soldernerd/SolarChargerHardware/SolarCharger_RevF_BOM.xlsx

Sheet: Sheet1
Quantity | Description | Value | Package | Manufacturer | Model | Marking | Farnell | Parts | Unit Price | Price | Price inkl MwSt
1 | Board | n/a | 78x85mm | soldernerd.com | Solar Charger Rev D | Solar Charger Rev F | n/a | n/a | 3 | 3 | 3.26
4 | 3-pin-header | n/a | 200 mil | Weidmueller | PM5.08/3/90 | n/a | 1131854 | CON1, CON6 | 0.26 | 1.04 | 1.13
1 | 5-pin header | ICSP | 100MIL_5X |  | CON_5X100MIL |  |  | CON3 | 0.5 | 0.5 | 0.54
1 | Type B USB 2.0 Connector | n/a | USB B | Multicomp | USB-B-S-RA | n/a | 2112373 | CON2 | 0.6 | 0.6 | 0.65
2 | Type A USB connector | n/a | USB_A | Multicomp | MC32593 | n/a | 1696534 | X3, X4 | 0.532 | 1.064 | 1.16
1 | Low-power 8bit microcontroller with USB | PIC18F47J53 | TQFP44 | Microchip | PIC18F47J53 | PIC18F47J53 | 1815001 | IC5 | 4.07 | 4.07 | 4.42
1 | Crystal | 8MHz | 5mm x 3.2mm | Abracon | ABM3-8.000MHZ-D2Y-T | 080 | 2101329 | X2 | 0.7 | 0.7 | 0.76
1 | Crystal | 32.768kHz | 3.2mm x 1.5mm | Abracon | ABS07-120-32.768KHZ-T |  | 2467864 | X1 | 0.762 | 0.762 | 0.83
1 | EEPROM | 16Kbit | SOT23-5 | Microchip | 24AA16T-I/OT | B5xx | 1331290 | IC8 | 0.35 | 0.35 | 0.38
1 | 32MBit Serial Flash | 32MBit | EIAJ SOIC8 | Adesto | AT45DB321E |  | 2414318 | IC10 | 2.47 | 2.47 | 2.68
1 | 16-Bit, 4-Channel Analog-to-Digital Converter | n/a | SO14 | Microchip | MCP3428 |  | 1801128 | IC1 | 3.1 | 3.1 | 3.37
1 | Voltage Reference | 2.5V | SOT23 | Texas Instruments | REF2925AIDBZR |  | 2459773 | IC6 | 1.1 | 1.1 | 1.20 | 2459773 | Texas | REF2925AIDBZR
1 | Analog Temperature Sensors with Class-AB Output | LMT86 | SC70-5 | Texas Instruments | LMT86 |  | 2314388 | IC7 | 0.551 | 0.551 | 0.60
2 | Current-Shunt Monitors | Gain=50 | SC70-6 | Texas Instruments | INA213AIDCKT |  | 1754261 | IC2, IC4 | 1.35 | 2.7 | 2.93
1 | 15V, 75mA, 800kHz High Efficient Buck Converter | TPS62120 | SOT-23-8 | Texas Instruments | TPS62120 |  | 1864820 | IC9 | 1.5 | 1.5 | 1.63
1 | Synchronous Step-Down Converter | TPS54428 | SOIC8_PWRPAD | Texas Instruments | TPS54428 |  | 2078519 | IC11 | 1.97 | 1.97 | 2.14
2 | 1.5A Dual MOSFET Driver | n/a | SSOP8 | Microchip | MCP14A0153-E/MS |  | 2524543 | IC12, IC13 | 0.76 | 1.52 | 1.65
1 | 85V Half-Bridge MOSFET Driver | n/a | SOIC8 | Microchip | MIC4605-1YM | MIC4605 | 2510168 | IC3 | 0.767 | 0.767 | 0.83
2 | Resistor | 7mOhms 1% 1W | 1206, metric 3216 | TE Connectivity | TLR2B10DR007FTDG | n/a | 2332217 | R3, R7 | 0.9 | 1.8 | 1.96
1 | Resistor | 5R6 | 0805, metric 2012 |  | RESISTORR0805 |  |  | R6 | 0.1 | 0.1 | 0.11
3 | Resistor | 1k | 0805, metric 2012 | Multicomp |  |  |  | R33, R34, R35 | 0.01 | 0.03 | 0.03
5 | Resistor | 10k | 0805, metric 2012 | Multicomp | MCWR08X1002FTL | 1002 | 2447553 | R2, R9, R11, R12, R13 | 0.01 | 0.05 | 0.05
1 | Resistor | 22k | 0805, metric 2012 | Multicomp | MC01W0805122K |  | 9332820 | R30 | 0.01 | 0.01 | 0.01
2 | Resistor | 27k | 0805, metric 2012 | Multicomp | MC01W0805127K |  | 9332952 | R25, R27 | 0.01 | 0.02 | 0.02
1 | Resistor | 43k | 0805, metric 2012 | Multicomp | MC01W0805143K |  | 9333223 | R19 | 0.01 | 0.01 | 0.01
2 | Resistor | 51k | 0805, metric 2012 | Multicomp | MC01W0805151K |  | 9333339 | R20, R22 | 0.01 | 0.02 | 0.02
2 | Resistor | 68k | 0805, metric 2012 | Multicomp | MC01W0805168K |  | 9333487 | R24, R26 | 0.01 | 0.02 | 0.02
1 | Resistor | 75k | 0805, metric 2012 | Multicomp | MC01W0805175K |  | 9333541 | R21 | 0.01 | 0.01 | 0.01
2 | Resistor | 100k | 0805, metric 2012 | Multicomp | MCWR08X1003FTL |  | 2447551 | R1, R8 | 0.01 | 0.02 | 0.02
1 | Resistor | 220k | 0805, metric 2012 | Multicomp | MC01W08051220K |  | 9332839 | R29 | 0.01 | 0.01 | 0.01
5 | Resistor | 300k | 0805, metric 2012 | Multicomp | MC01W08051300K |  | 9333010 | R5, R10, R17, R28, R32 | 0.01 | 0.05 | 0.05
4 | Resistor | 620k | 0805, metric 2012 | Multicomp | MC01W08051620K |  | 9333444 | R4, R14, R16, R31 | 0.01 | 0.04 | 0.04
2 | Ceramic capacitor | 6p8 | 0805, metric 2012 |  | CC0805 |  |  | C18, C19 | 0.2 | 0.4 | 0.43
4 | Ceramic capacitor | 15p | 0805, metric 2012 |  | CC0805 |  |  | C20, C21, C27, C42 | 0.2 | 0.8 | 0.87
25 | Ceramic capacitor | 100nF, 50V, X7R | 0805, metric 2012 | Multicomp | MC0805B104K500CT | n/a | 1759265 | C1, C2, C3, C7, C8, C9, C11, C12, C13, C14, C16, C17, C23, C24, C26, C29, C30, C33, C34, C36, C37, C38, C41, C43, C44 | 0.015 | 0.375 | 0.41
5 | Ceramic capacitor | 1u 25V | 0805, metric 2012 | Murata | GRM219R71E105KA88D |  | 1845770 | C22, C35, C45, C46, C47 | 0.052 | 0.26 | 0.28
4 | Ceramic capacitor | 10uF, 25V, X7R | 1206, metric 3216 | Multicomp | MC0805B106K6R3CT | n/a | 2320851 | C6, C25, C31, C32 | 0.062 | 0.248 | 0.27
4 | Ceramic capacitor | 22u 6V3 | 1206, metric 3216 | TDK | C3216X5R0J226M085AC |  | 2526272 | C15, C28, C39, C40 | 0.16 | 0.64 | 0.70
3 | Electrolytic capacitor | 470u 25V | 10mm x 12.5mm | Panasonic | EEUFR1E471B |  | 1800650 | C4, C5, C10 | 0.27 | 0.81 | 0.88
1 | Inductor | 18u | 2.95mm x 2.95mm x 1.4mm | Coilcraft | LPS3015-183MRB |  | 2408026 | L2 | 0.95 | 0.95 | 1.03
1 | Inductor | 4.7u | 10.2mm x 10.2mm x 4.8mm | Coilcraft | MSS1048-472NLC |  | 2288282 | L3 | 1.86 | 1.86 | 2.02
1 | Inductor | 22uH | 12mm x 12mm | Coilcraft | MSS1210-223MED | 226 | 2288332 | L1 | 2.5 | 2.5 | 2.72
4 | Schottky diode | n/a | SOD123-W | NXP | PMEG3010BER | n/a | 1907684 | D1, D2, D3, D4 | 0.17 | 0.68 | 0.74
1 | Zener diode | 15V | DO214AC |  |  |  |  | D6 | 0.3 | 0.3 | 0.33
1 | Zener diode | 18V | DO214AC |  |  |  |  | D5 | 0.3 | 0.3 | 0.33
6 | N-Channel MOSFET | n/a | SOT23 | NXP | NX3008NBKW |  | 2069546 | Q1, Q3, Q7, Q8, Q9, Q15 | 0.05 | 0.3 | 0.33
2 | P-channel MOSFET | n/a | SOT23 | On Semiconductor | NTR4101PT1G |  | 2124699 | Q4, Q10 | 0.14 | 0.28 | 0.30
7 | N-Channel MOSFET | 30V | LFPAK / SOT669 | NXP | PSMN6R0-30YL |  | 1699709 | Q2, Q5, Q6, Q11, Q12, Q13, Q14 | 0.425 | 2.975 | 3.23
 |  |  |  |  |  |  |  |  |  | 43.632 | 47.42608696
 |  |  |  |  |  |  |  |  |  |  | 49.40217391
 |  |  |  |  |  |  |  |  |  |  | 51.46059783
 |  |  |  |  |  |  |  |  |  |  | 75
 |  |  |  |  |  |  |  |  |  |  | 2.5
 |  |  |  |  |  |  |  |  |  |  | 187.5

Sheet: Sheet2
Qty | Value | Device | Package | Parts | Description
1 | 24AA16 | 24AA16 | SOT-23-5 | IC8 | 16K I2C Serial EEPROM
1 | AT45DB321E | AT45DB161EEIAJ | EIAJ_SOIC8 | IC10 | 16-Mbit DataFlash
3 | 470u 25V | C_POLARIZED10MM | 10MM | C4, C5, C10
25 | 100n | CC0805 | C0805 | C1, C2, C3, C7, C8, C9, C11, C12, C13, C14, C16, C17, C23, C24, C26, C29, C30, C33, C34, C36, C37, C38, C41, C43, C44 | Capacitor
4 | 15p | CC0805 | C0805 | C20, C21, C27, C42 | Capacitor
5 | 1u | CC0805 | C0805 | C22, C35, C45, C46, C47 | Capacitor
2 | 6p8 | CC0805 | C0805 | C18, C19 | Capacitor
4 | 10u 25V | CC1206 | C1206 | C6, C25, C31, C32 | Capacitor
4 | 22u 6V3 | CC1206 | C1206 | C15, C28, C39, C40 | Capacitor
1 | CON_2X100MIL | CON_2X100MIL | 100MIL_2X | CON7 | 2-pin header
2 | CON_3X100MIL | CON_3X100MIL | 100MIL_3X | CON4, CON5 | 3-pin header
1 | I2C | CON_4X100MIL | 100MIL_4X | CON8 | 4-pin header
1 | CON_4X200MIL | CON_4X200MIL | 200MIL_4X | CON1 | 4-pin header
1 | CON_5X100MIL | CON_5X100MIL | 100MIL_5X | CON11 | 5-pin header
1 | SPI | CON_6X3X2 | 100MIL_3X2 | CON9 | 6-pin header
1 | CON_8X200MIL | CON_8X200MIL | 200MIL_8X | CON6 | 8-pin header
1 | ABS07-120-32.768KHZ-T | CRYSTAL3.2X1.5 | 3.2X1.5MM | X1 | Crystal
1 | ABM3-8.000MHZ-D2Y-T | CRYSTAL5X3.2MM | 5X3.2MM | X2 | Crystal
1 | DISPLAY_UNIT | DISPLAY_UNIT | DISPLAY_UNIT | BRD1 | Display Unit
2 | INA213 | INA21 | SC70-6 | IC2, IC4 | Current-Shunt Monitors
1 | 18u | INDUCTORLPS3015 | LPS3015 | L2
1 | 4.7u | INDUCTORMSS1038 | MSS1038 | L3
1 | 22uH | INDUCTORMSS1210 | MSS1210 | L1
1 | LMT86 | LMT86 | SC70-5 | IC7 | Analog Temperature Sensors with Class-AB Output
2 | MCP14A0153 | MCP14A0153 | SSOP8 | IC12, IC13 | 1.5A Dual MOSFET Driver with Low Threshold Input And Enable
1 | MCP3428 | MCP3428 | SO14 | IC1 | 16-Bit, 4-Channel ΔΣ Analog-to-Digital Converter with
1 | MIC4605-1YM | MIC4605 | SOIC8 | IC3 | 85V Half-Bridge MOSFET Driver with adaptive Dead Time
6 | NX3008NBKW | N-FETSOT23 | SOT23 | Q1, Q3, Q7, Q8, Q9, Q15 | N-Channel MOSFET
4 | N-FET | N-PWR-MOSFETLFPAK | LFPAK | Q11, Q12, Q13, Q14
3 | PSMN6R0-30YL | N-PWR-MOSFETLFPAK | LFPAK | Q2, Q5, Q6
1 | PCB_115_90 | PCB_115_90 | PCB_115_90 | DRL1
2 | NTR4101PT1G | P-FETSOT23 | SOT23 | Q4, Q10
1 | PIC18F47J53 | PIC18F46J50 | TQFP44 | IC5 | Low-power 8bit microcontroller with USB
2 | 100k | RESISTORR0805 | R0805 | R1, R8 | RESISTOR, European symbol
5 | 10k | RESISTORR0805 | R0805 | R2, R9, R11, R12, R13 | RESISTOR, European symbol
3 | 1k | RESISTORR0805 | R0805 | R33, R34, R35 | RESISTOR, European symbol
1 | 220k | RESISTORR0805 | R0805 | R29 | RESISTOR, European symbol
1 | 22k | RESISTORR0805 | R0805 | R30 | RESISTOR, European symbol
2 | 27k | RESISTORR0805 | R0805 | R25, R27 | RESISTOR, European symbol
5 | 300k | RESISTORR0805 | R0805 | R5, R10, R17, R28, R32 | RESISTOR, European symbol
1 | 43k | RESISTORR0805 | R0805 | R19 | RESISTOR, European symbol
2 | 51k | RESISTORR0805 | R0805 | R20, R22 | RESISTOR, European symbol
1 | 5R6 | RESISTORR0805 | R0805 | R6 | RESISTOR, European symbol
4 | 620k | RESISTORR0805 | R0805 | R4, R14, R16, R31 | RESISTOR, European symbol
2 | 68k | RESISTORR0805 | R0805 | R24, R26 | RESISTOR, European symbol
1 | 75k | RESISTORR0805 | R0805 | R21 | RESISTOR, European symbol
2 | TBD | RESISTORR0805 | R0805 | R18, R23 | RESISTOR, European symbol
2 | R007 | RESISTORR1206 | R1206 | R3, R7 | RESISTOR, European symbol
4 | PMEG3010BER | SCHOTTKYSOD123 | SOD123 | D1, D2, D3, D4
1 | TPS54428 | TPS54428 | SOIC8_PWRPAD | IC11 | 4.5V to 18V Input, 4-A Synchronous Step-Down Converter with Eco-mode
1 | TPS62120 | TPS62120 | SOT-23-8 | IC9 | 15V, 75mA, 800kHz High Efficient Buck Converter
1 | TI_REF2925 | TS6001 | SOT23 | IC6 | 2.5V Voltage Reference in SOT23
2 | USB_A | USB_A | USB_A | X3, X4
1 | USB_BMULTICOMP | USB_BMULTICOMP | USB_B | CON2 | Type B USB connector
1 | 15V | ZENERDO214 | DO214AC | D6
1 | 18V | ZENERDO214 | DO214AC | D5
2 USB_A USB_A USB_A X3, X4
1 USB_BMULTICOMP USB_BMULTICOMP USB_B CON2 Type B USB connector
