soldernerd/SolarChargerHardware/(threads)

Thread 1 (2020-04-01):

Additional feature request

Mssekibaala, 2020-04-01:
It would be nice for the charger pcb to expose an interrupt pin and at least 2 GPIO pins. Perhaps a Version G?

soldernerd, 2020-04-15:
There are no pins left on the microcontroller but you can potentially use the two external temperature sensor inputs for that purpose

Mssekibaala, 2020-04-16:
Thank you Lukas. Let me look into it that. This is my first time working
with the PIC MCU coming from an Arduino only background but I am sure I'll
figure it. Thanks for putting this out there for us all to use.

Cheers

On Wed, Apr 15, 2020 at 5:35 PM Lukas Fässler <notifications@github.com>
wrote:

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
