soldernerd/SolarChargerHardware/SolarCharger_Rev2_Board.pdf

Q1
L1

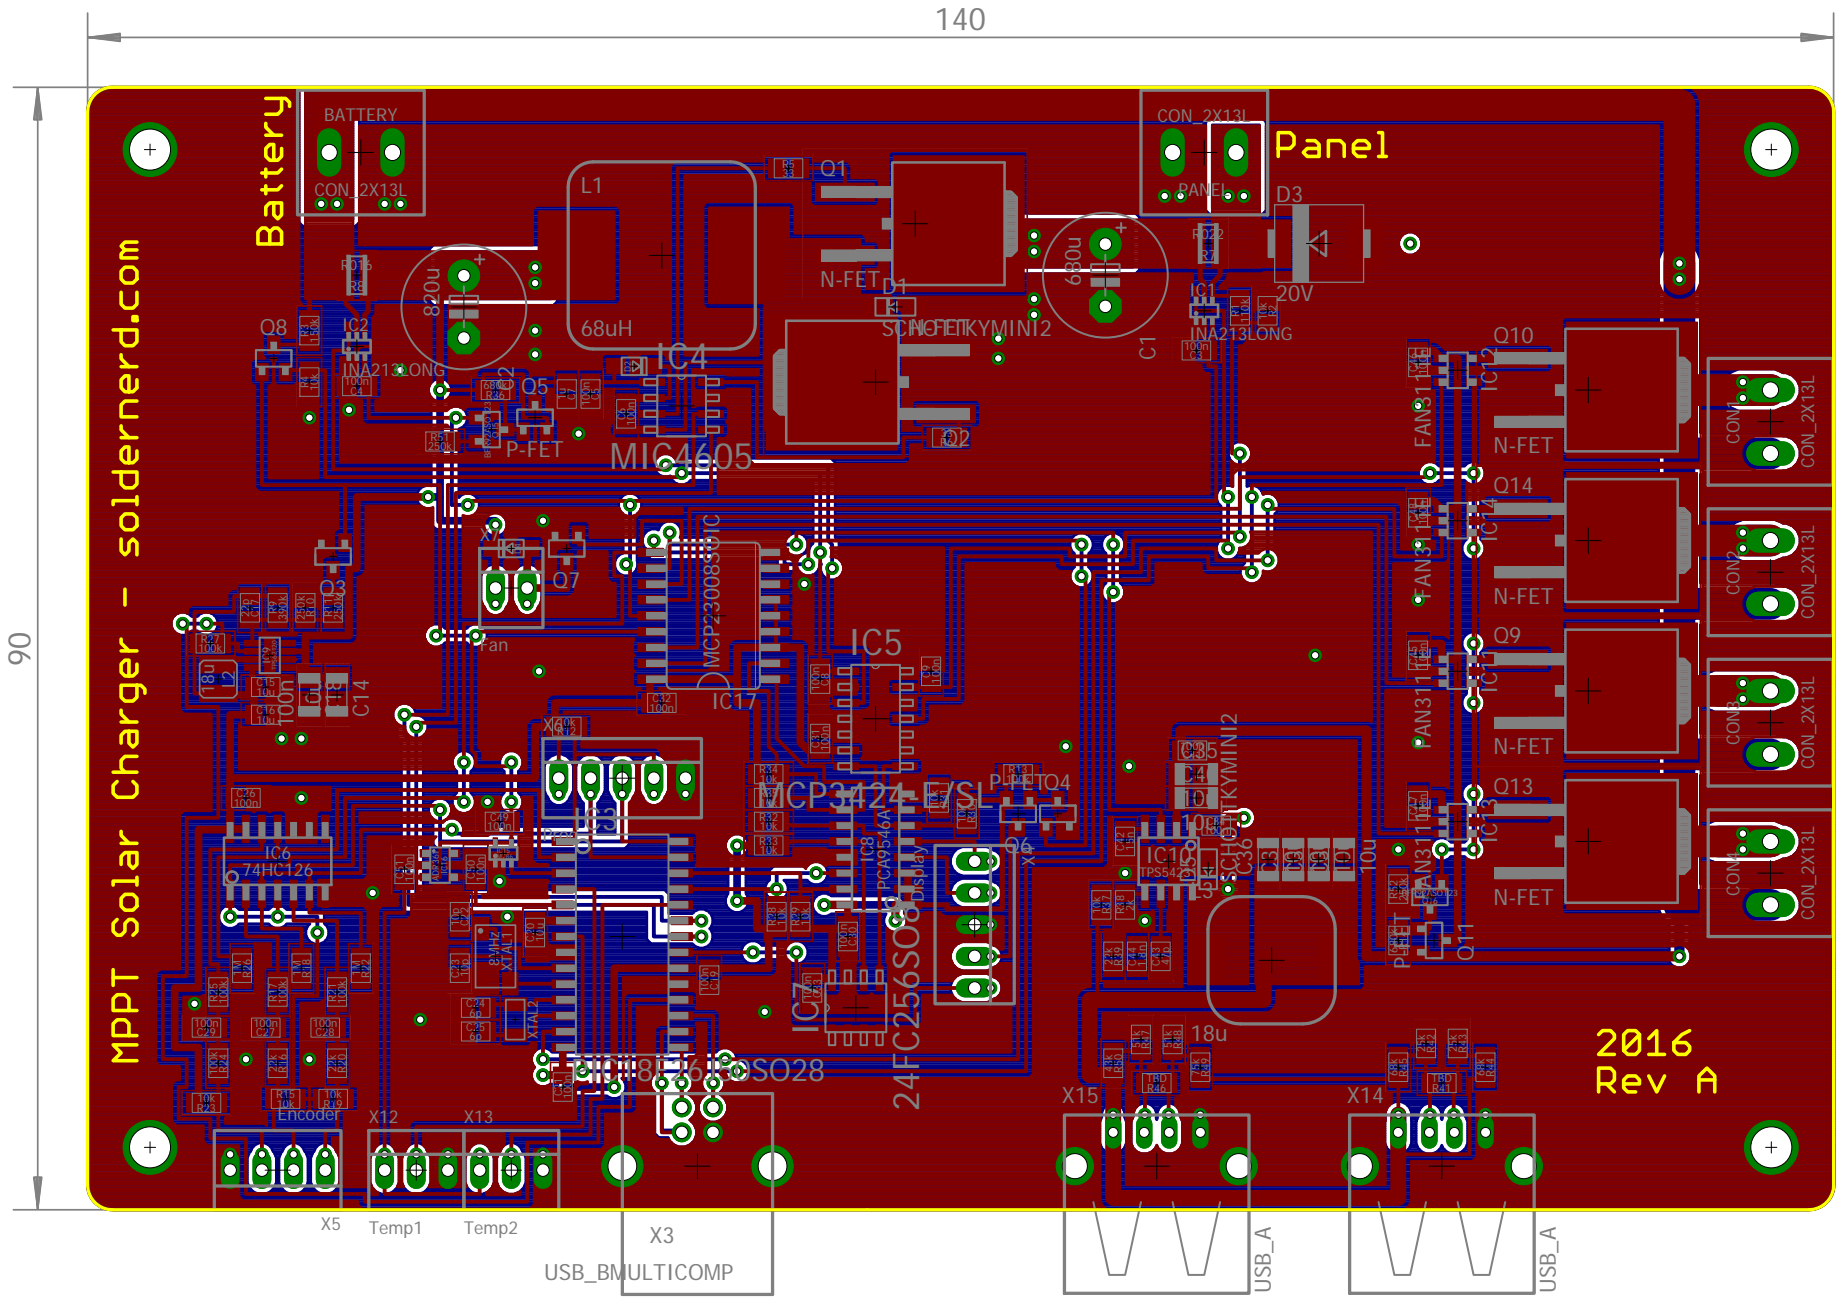
[picture p1: page 1]

MIC4605 P-FET
