soldernerd/SolarChargerHardware/SolarCharger_Rev2_Schematic.pdf

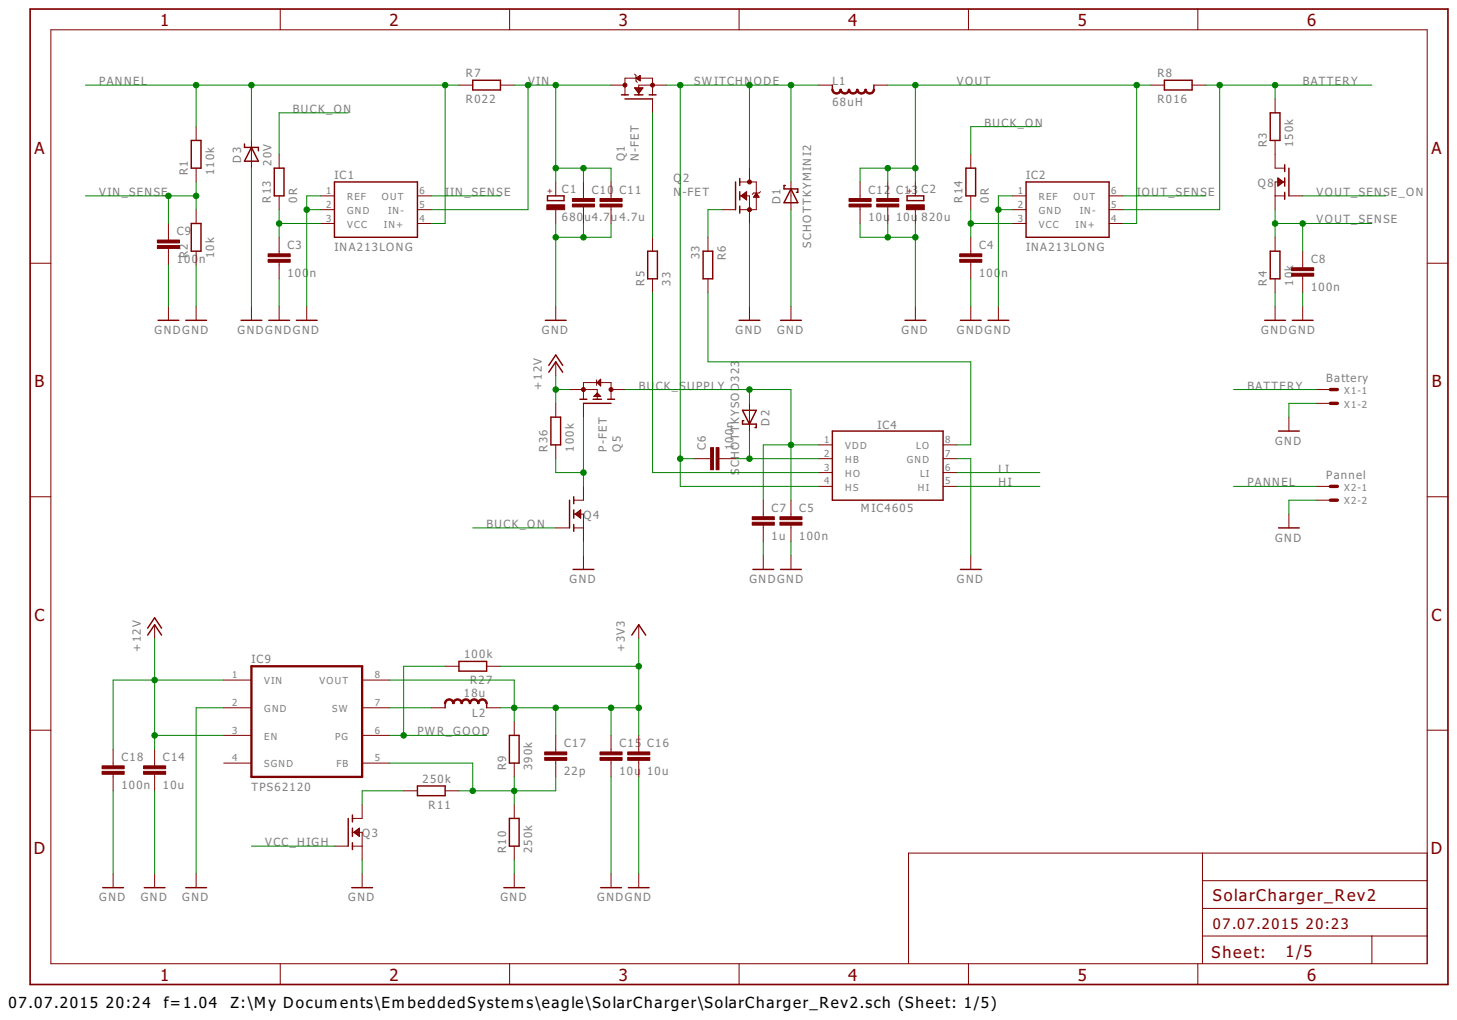
[picture p2: page 1]

07.07.2015 20:24 f=1.04 Z:\My Documents\EmbeddedSystems\eagle\SolarCharger\SolarCharger_Rev2.sch (Sheet: 1/5)

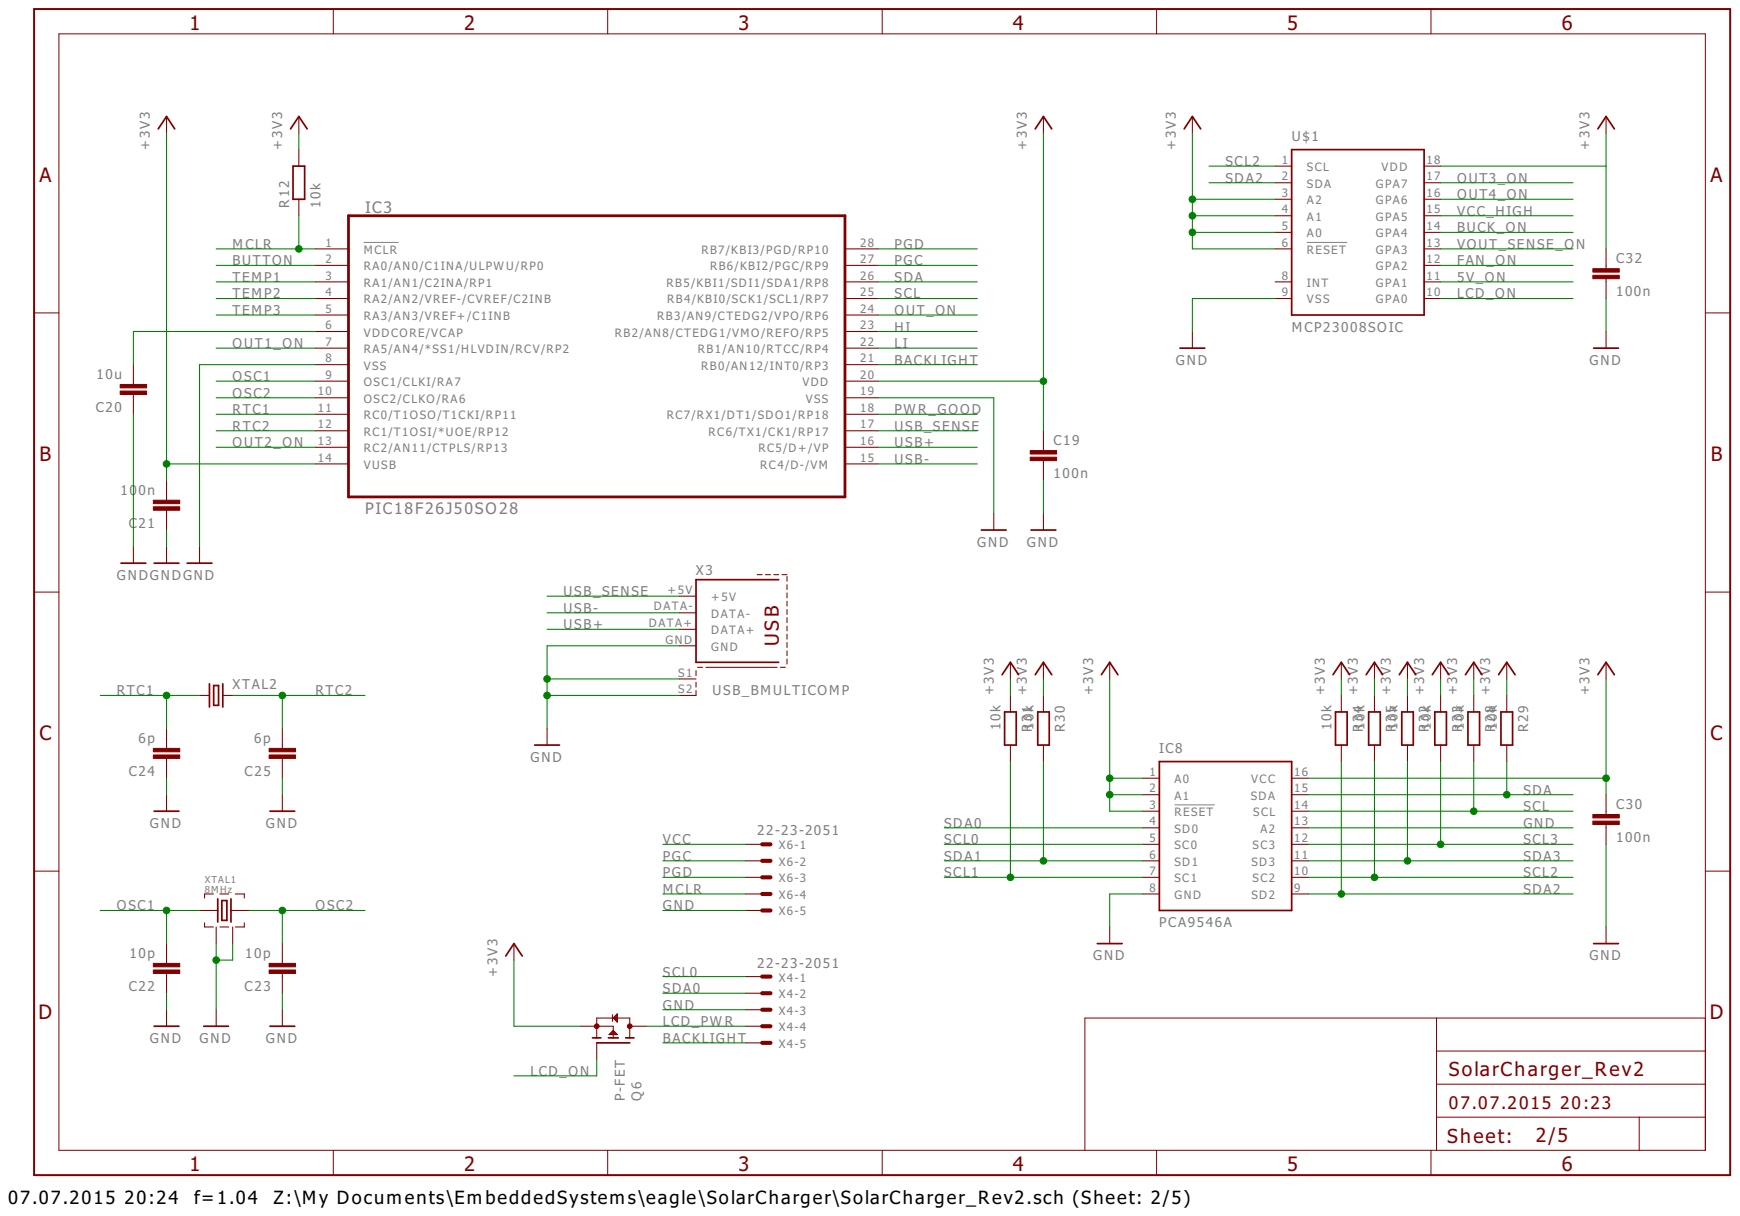
[picture p3: page 2]

07.07.2015 20:24 f=1.04 Z:\My Documents\EmbeddedSystems\eagle\SolarCharger\SolarCharger_Rev2.sch (Sheet: 2/5)

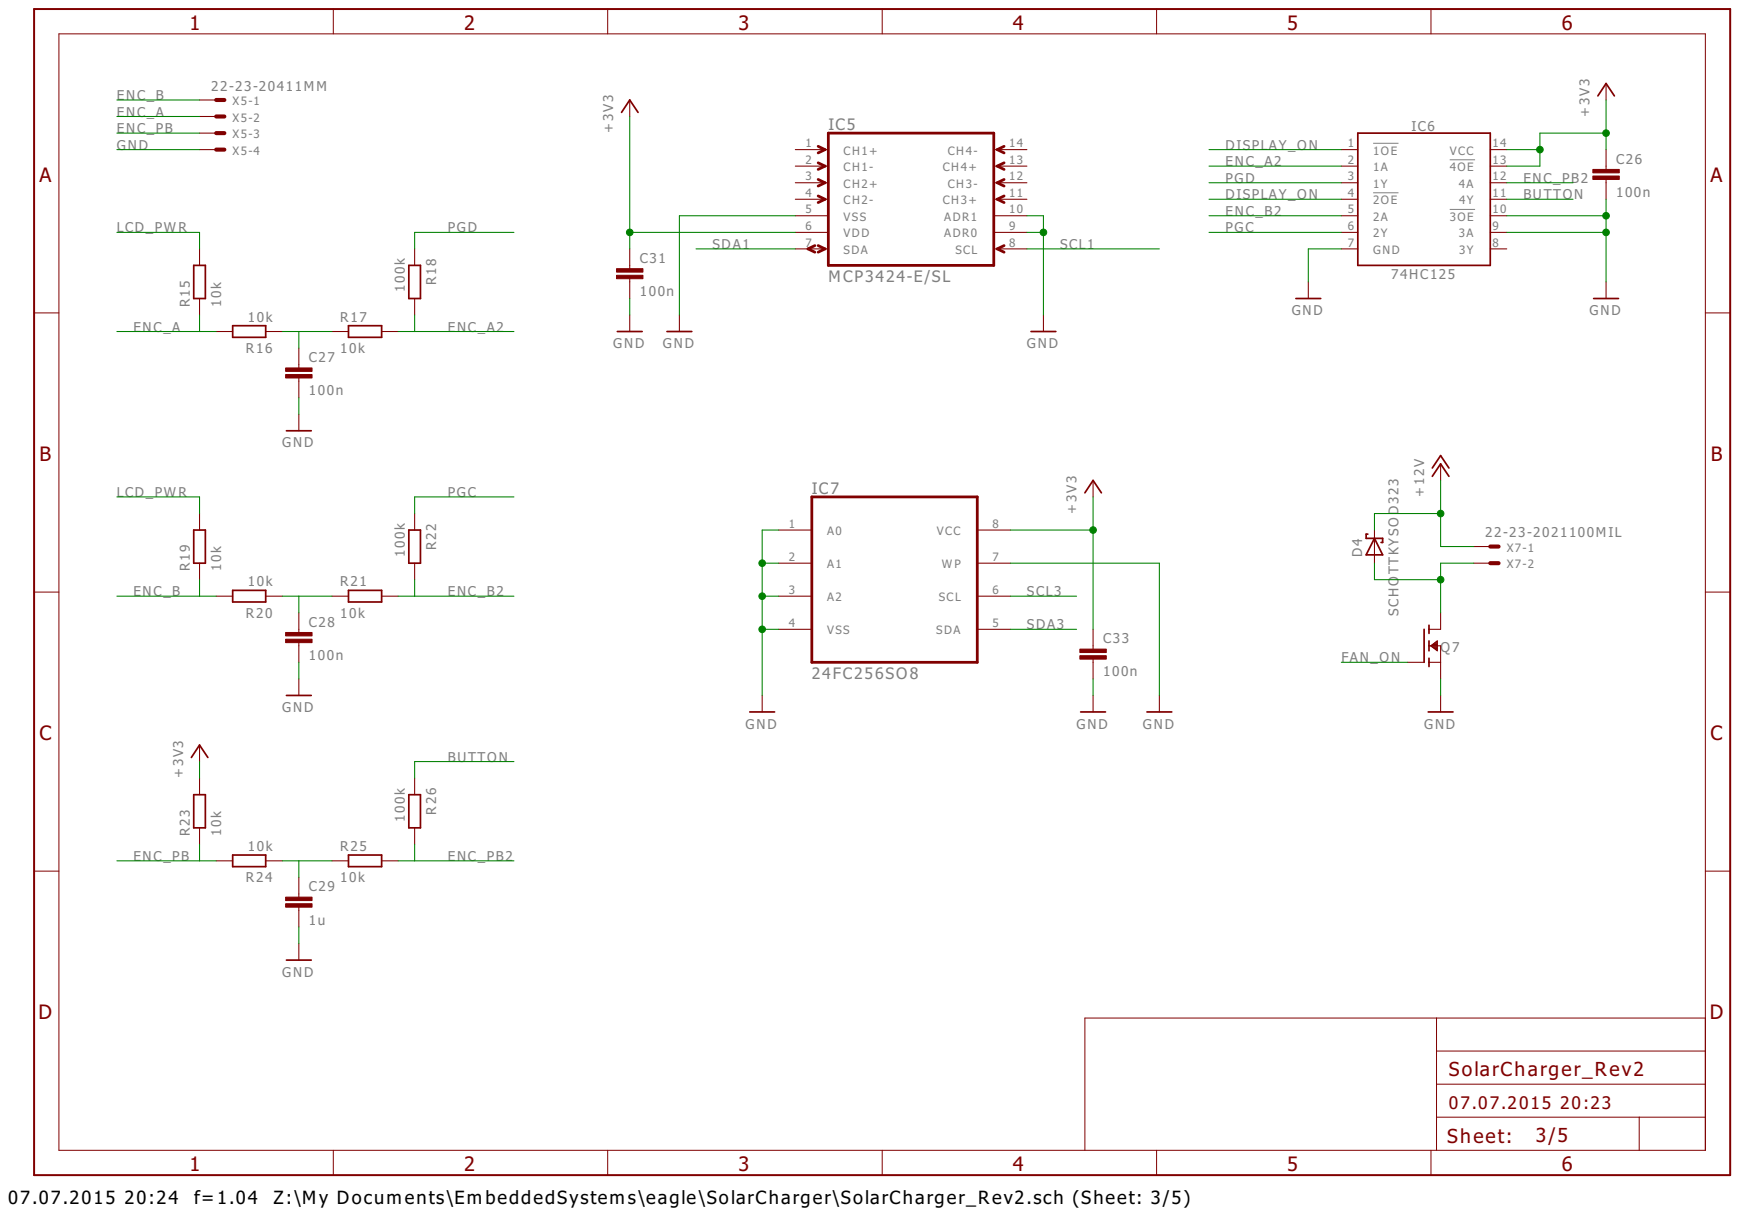
[picture p4: page 3]

07.07.2015 20:24 f=1.04 Z:\My Documents\EmbeddedSystems\eagle\SolarCharger\SolarCharger_Rev2.sch (Sheet: 3/5)

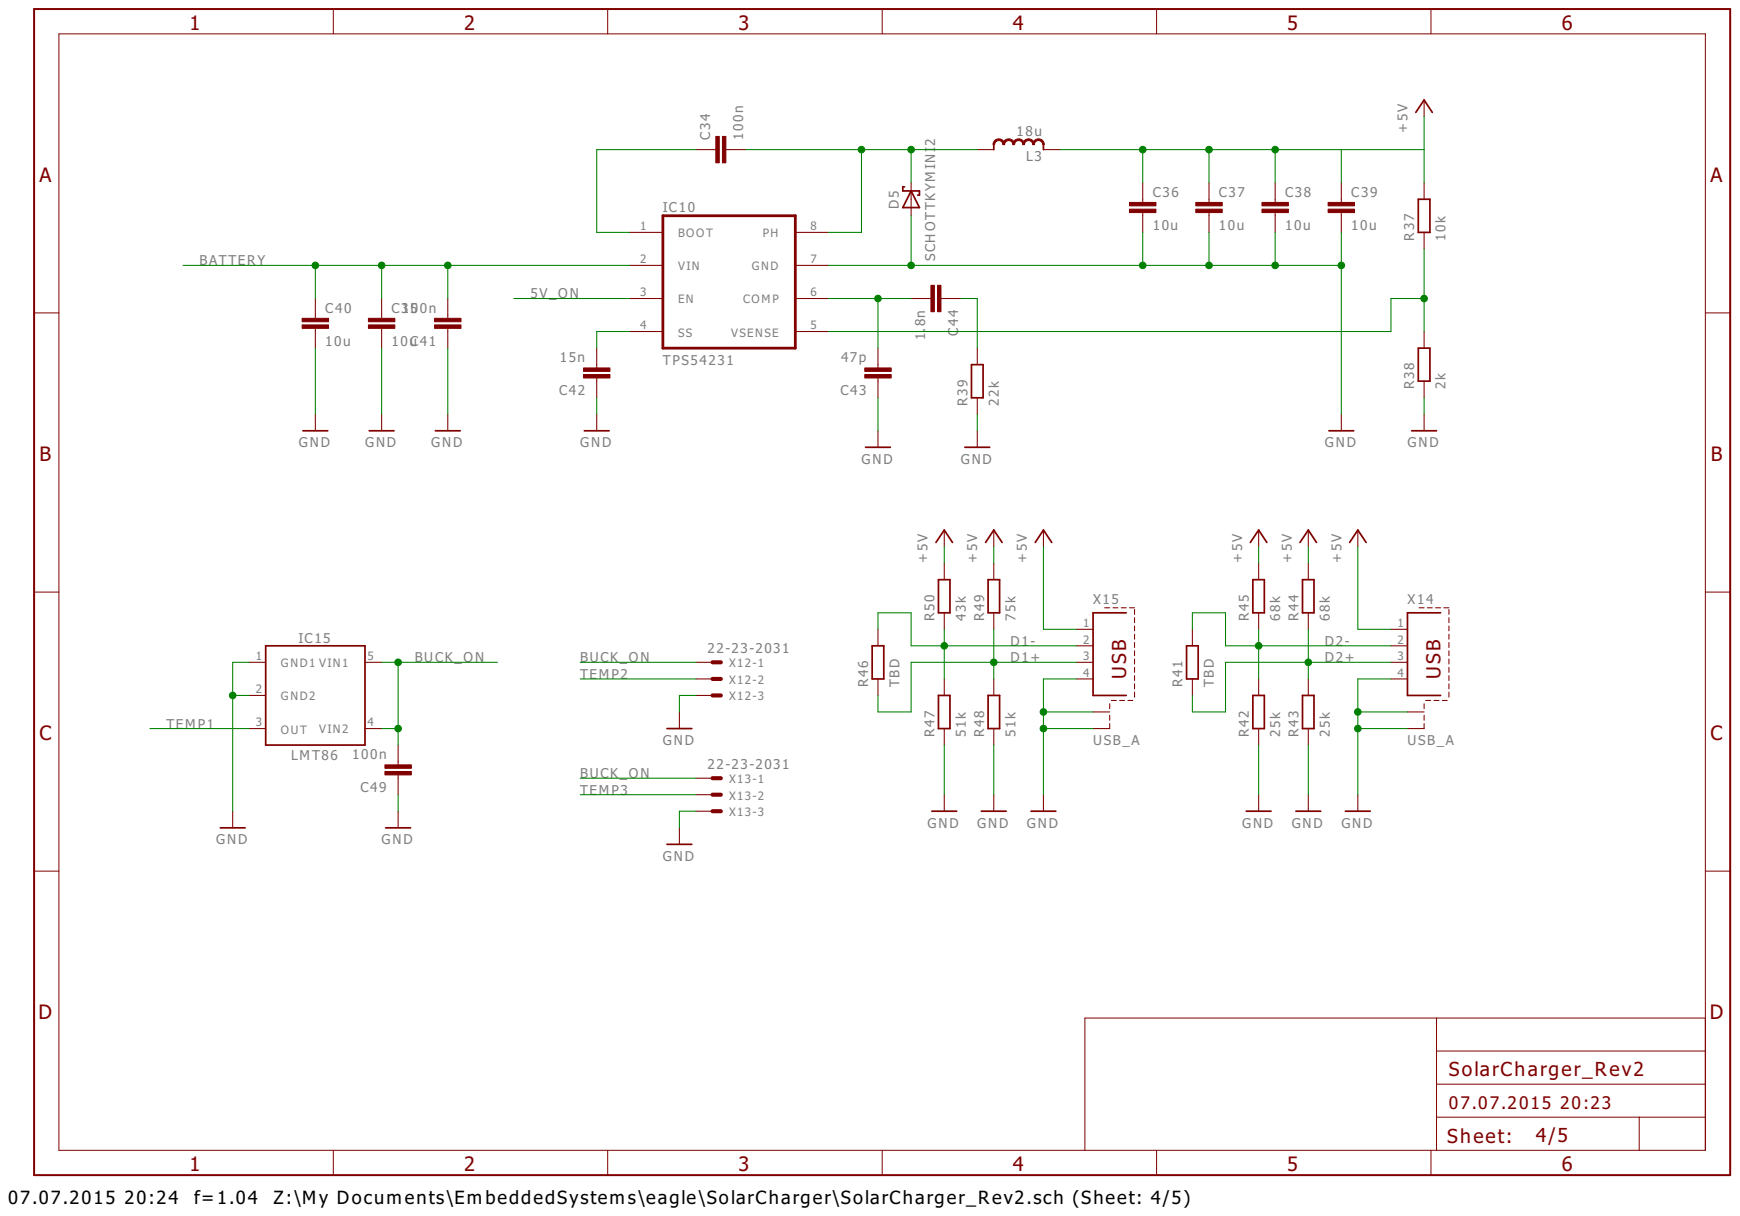
[picture p5: page 4]

07.07.2015 20:24 f=1.04 Z:\My Documents\EmbeddedSystems\eagle\SolarCharger\SolarCharger_Rev2.sch (Sheet: 4/5)

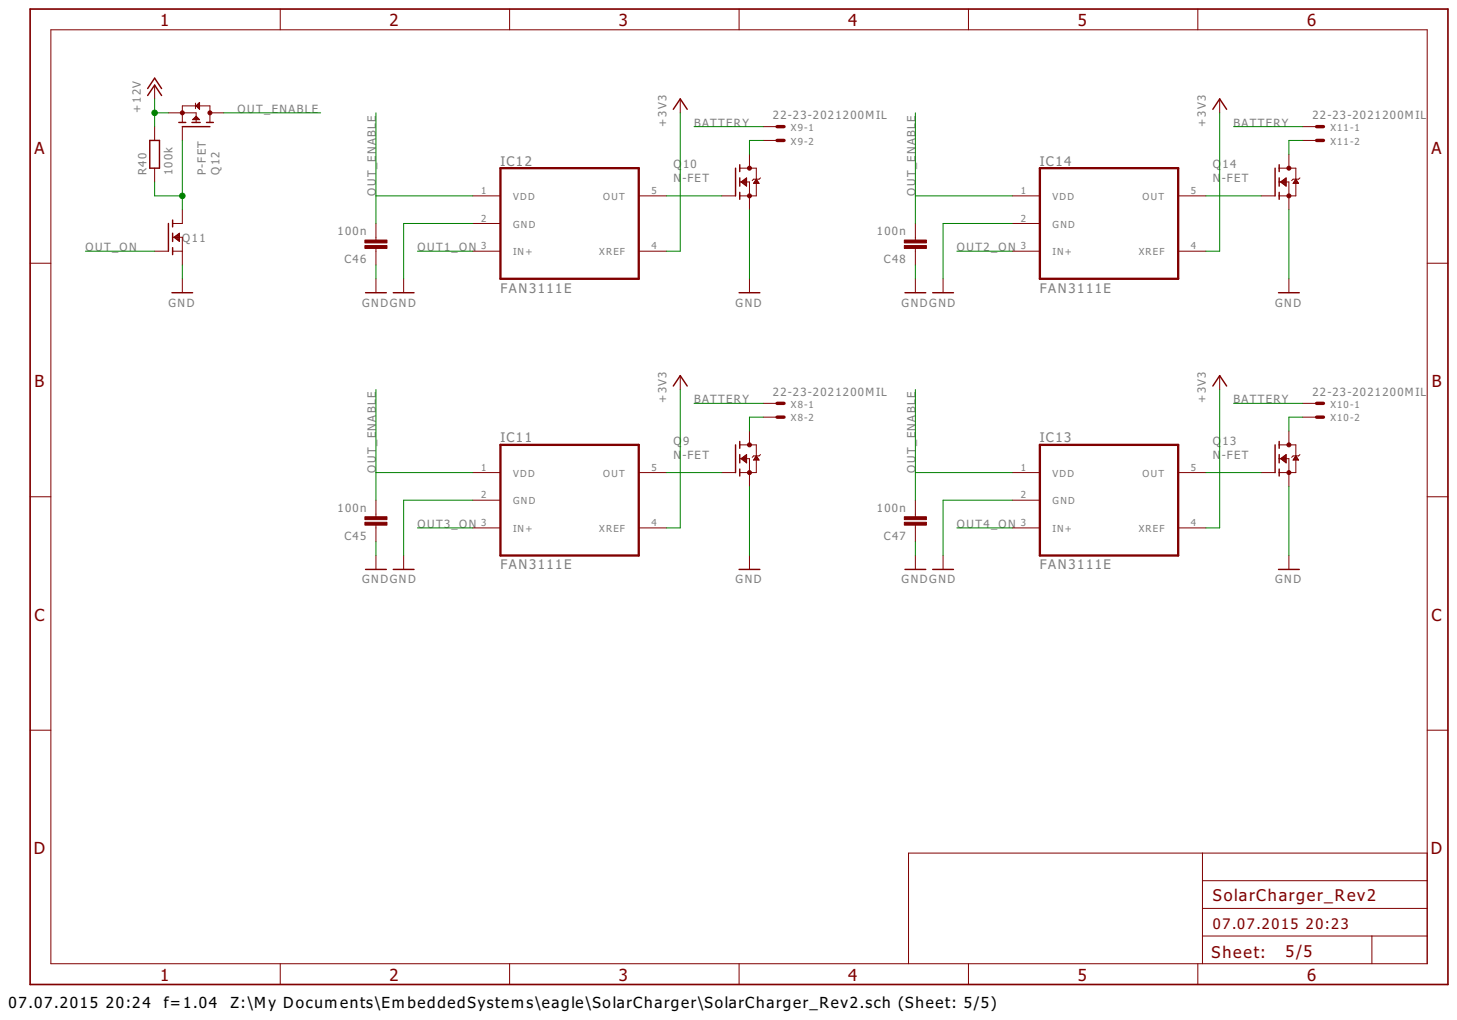
[picture p6: page 5]

07.07.2015 20:24 f=1.04 Z:\My Documents\EmbeddedSystems\eagle\SolarCharger\SolarCharger_Rev2.sch (Sheet: 5/5)
