soldernerd/SolarChargerHardware/SolarCharger_Rev1_Board.pdf

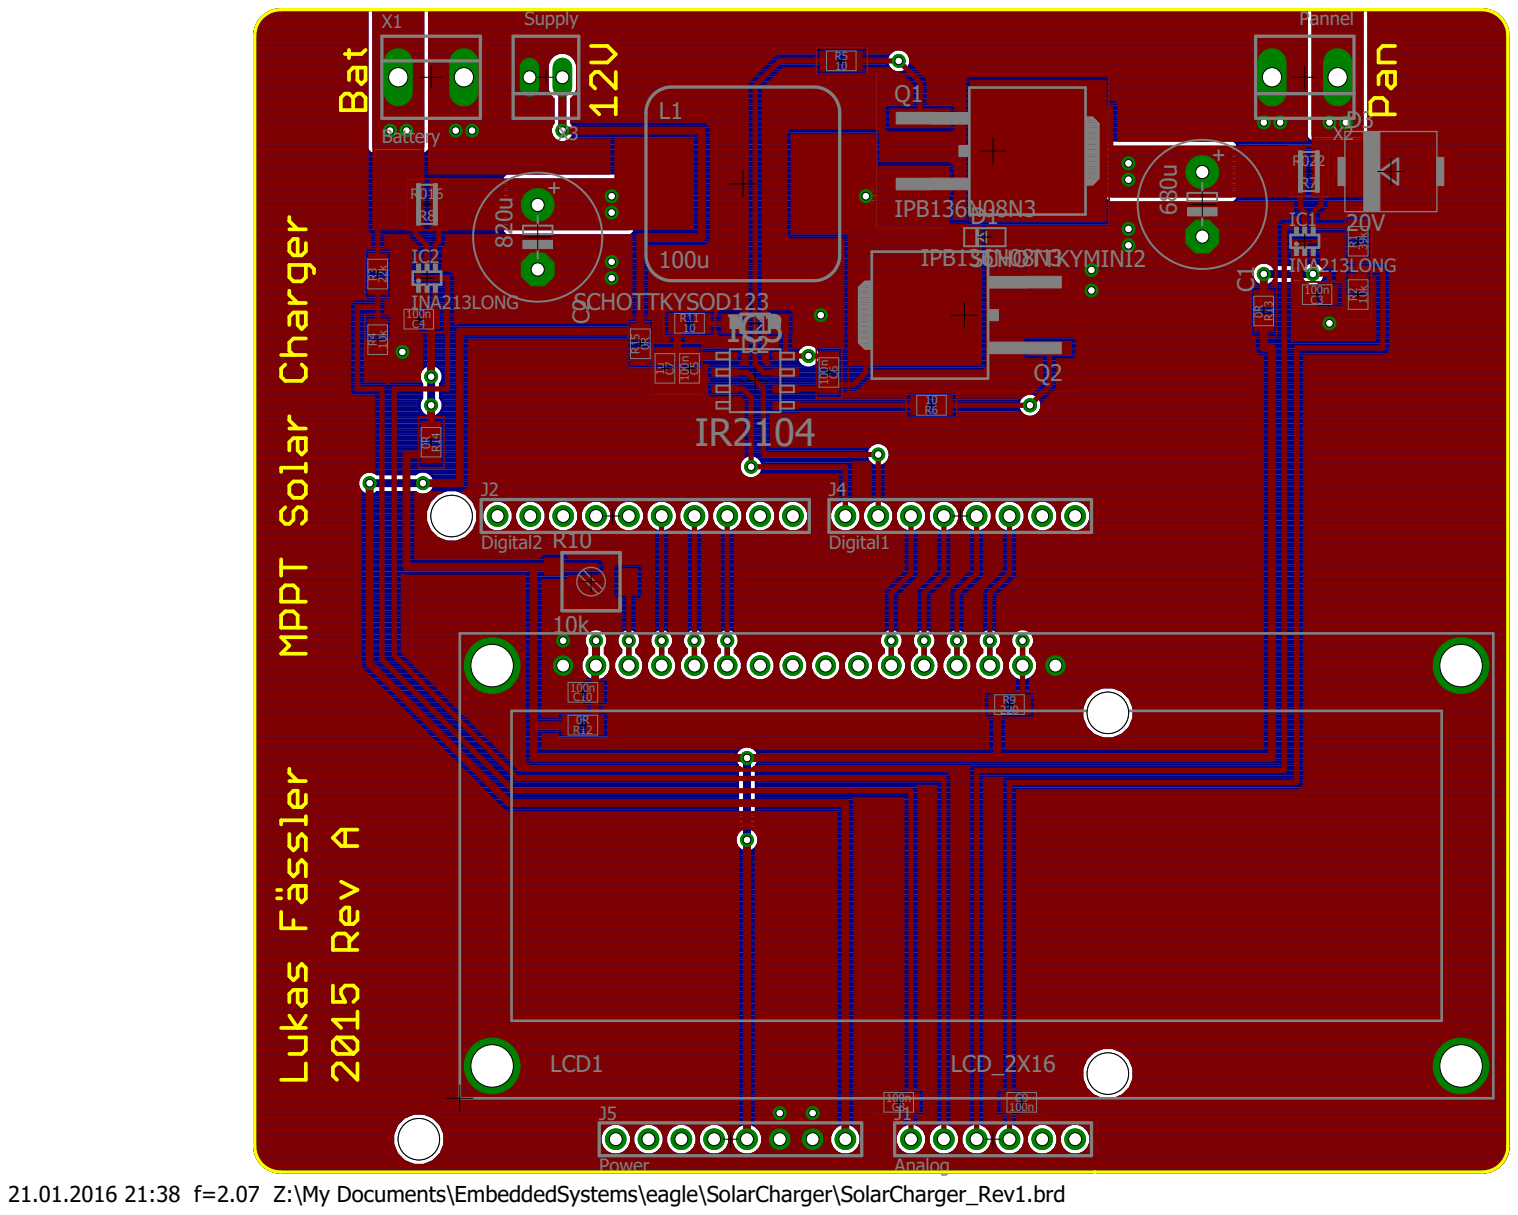
[picture p7: page 1]

X1 | Supply Pannel

R5
10
Q1

R022
R7

R016
R8 | D1 | IC1 | 20V

IPB136N08N3

IC2 | 100u | IPB13S6CNH0O8TNT3KYMINI2

INA213LONG

INA213LONG | SCHOTTKYSOD123
C3 C4
100n

R6

C10 | R9

0R
R12

21.01.2016 21:38 f=2.07 Z:\My Documents\EmbeddedSystems\eagle\SolarCharger\SolarCharger_Rev1.brd
