soldernerd/SolarChargerHardware/SolarCharger_Rev1_Schematic.pdf

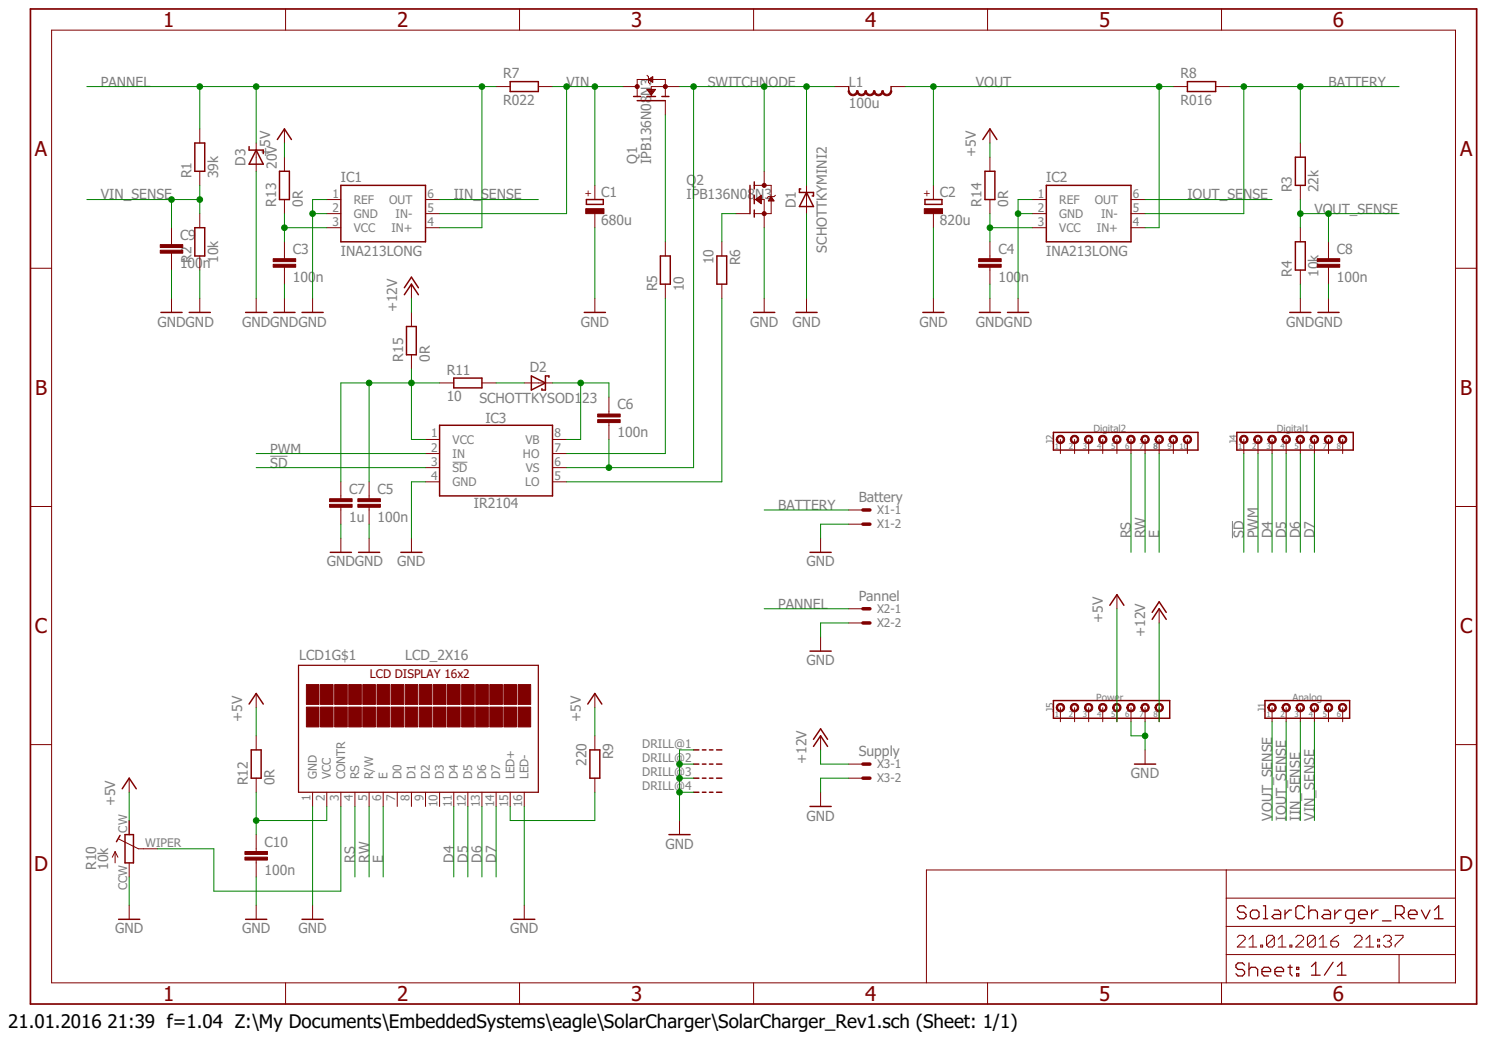
[picture p8: page 1]

21.01.2016 21:39 f=1.04 Z:\My Documents\EmbeddedSystems\eagle\SolarCharger\SolarCharger_Rev1.sch (Sheet: 1/1)
