soldernerd/SolarChargerHardware/SolarCharger_Rev1_revised.brd

## EAGLE design SolarCharger_Rev1_revised.brd (2018-06-25)

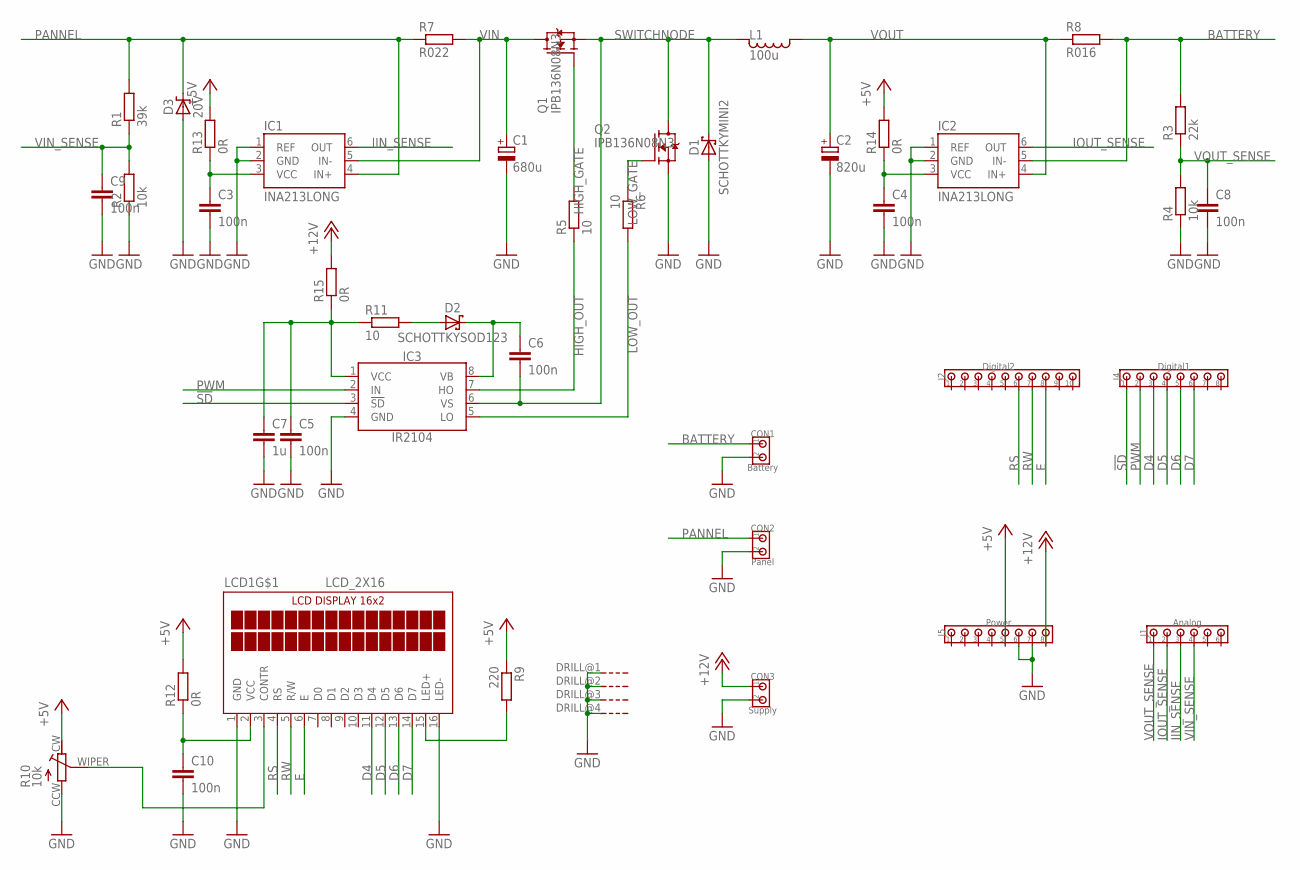
[picture p9: schematic SolarCharger_Rev1_revised.sch]

Parts:
C1: 680u; 10MM
C2: 820u; 10MM
C3, C4, C5, C6, C8, C9, C10: 100n; C0805
C7: 1u; C0805
CON1: Battery; 200MIL_2X
CON2: Panel; 200MIL_2X
CON3: Supply; 200MIL_2X
D1: SCHOTTKYMINI2; MINI2-F3-B
D2: SCHOTTKYSOD123; SOD123
D3: 20V; SMC
IC1, IC2: INA213LONG; SC70-6_LONG
IC3: IR2104; SOIC8
J1: Analog; 100MIL_6X_ROUND
J2: Digital2; 100MIL_10X_ROUND
J4: Digital1; 100MIL_8X_ROUND
J5: Power; 100MIL_8X_ROUND
L1: 100u; MSS1583
LCD1: LCD_2X16
Q1: IPB136N08N3; TO263-3
Q2: IPB136N08N3; TO263-3@1
R1: 39k; R0805
R2, R4: 10k; R0805
R3: 22k; R0805
R5, R6, R11: 10; R0805
R7: R022; 0612
R8: R016; 0612
R9: 220; R0805
R10: 10k; RTRIM3314G
R12, R13, R14, R15: 0R; R0805

Connections:
!SD!: IC3.3 (!SD!), J4.1
+5V: J5.5, R9.1, R10.CW, R12.2, R13.2, R14.2
+12V: CON3.1, J5.8, R15.2
BATTERY: CON1.1, IC2.5 (IN-), R3.2, R8.2
BOOT: C6.1, D2.C, IC3.8 (VB)
D4: J4.3, LCD1.11 (D4)
D5: J4.4, LCD1.12 (D5)
D6: J4.5, LCD1.13 (D6)
D7: J4.6, LCD1.14 (D7)
E: J2.8, LCD1.6 (E)
GND: C1.-, C2.-, C3.2, C4.2, C5.2, C7.2, C8.2, C9.2, C10.2, CON1.2, CON2.2, CON3.2, D1.A, D3.A, IC1.1 (REF), IC1.2 (GND), IC2.1 (REF), IC2.2 (GND), IC3.4 (GND), J5.6, J5.7, LCD1.1 (GND), LCD1.16 (LED-), LCD1.DRILL@1 (G), LCD1.DRILL@2 (G), LCD1.DRILL@3 (G), LCD1.DRILL@4 (G), Q2.3 (S), R2.1, R4.1, R10.CCW
HIGH_GATE: Q1.1 (G), R5.2
HIGH_OUT: IC3.7 (HO), R5.1
IIN_SENSE: IC1.6 (OUT), J1.3
IOUT_SENSE: IC2.6 (OUT), J1.2
LOW_GATE: Q2.1 (G), R6.1
LOW_OUT: IC3.5 (LO), R6.2
unnamed: C10.1, LCD1.2 (VCC), R12.1
unnamed: C3.1, IC1.3 (VCC), R13.1
unnamed: C4.1, IC2.3 (VCC), R14.1
unnamed: C5.1, C7.1, IC3.1 (VCC), R11.1, R15.1
unnamed: LCD1.15 (LED+), R9.2
unnamed: LCD1.3 (CONTR), R10.WIPER
unnamed: D2.A, R11.2
PANNEL: CON2.1, D3.C, IC1.4 (IN+), R1.2, R7.1
PWM: IC3.2 (IN), J4.2
RS: J2.6, LCD1.4 (RS)
RW: J2.7, LCD1.5 (R/W)
SWITCHNODE: C6.2, D1.C, IC3.6 (VS), L1.2, Q1.3 (S), Q2.TAB (D)
VIN: C1.+, IC1.5 (IN-), Q1.TAB (D), R7.2
VIN_SENSE: C9.1, J1.4, R1.1, R2.2
VOUT: C2.+, IC2.4 (IN+), L1.1, R8.1
VOUT_SENSE: C8.1, J1.1, R3.1, R4.2

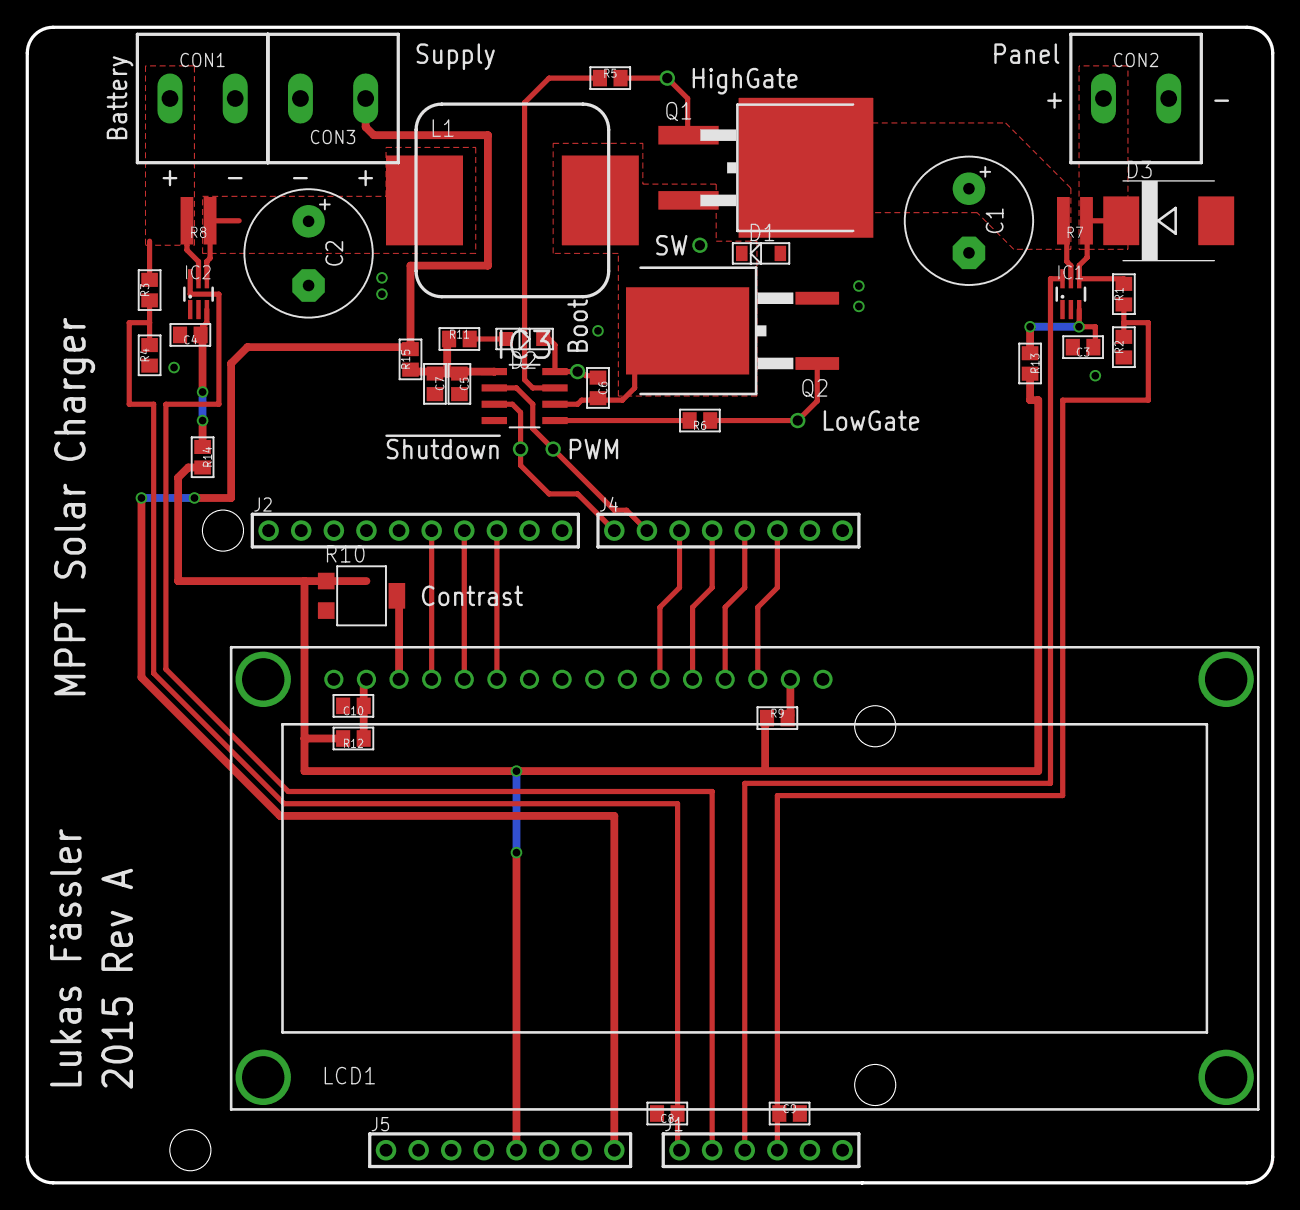
[picture p10: board SolarCharger_Rev1_revised.brd from above]

Board: 2 copper layers, 97.0 x 90.0 mm, 42 parts (0 on the bottom side), 33 nets.
