soldernerd/SolarChargerHardware/SolarCharger_RevF.brd

## EAGLE design SolarCharger_RevF.brd (2018-02-18)

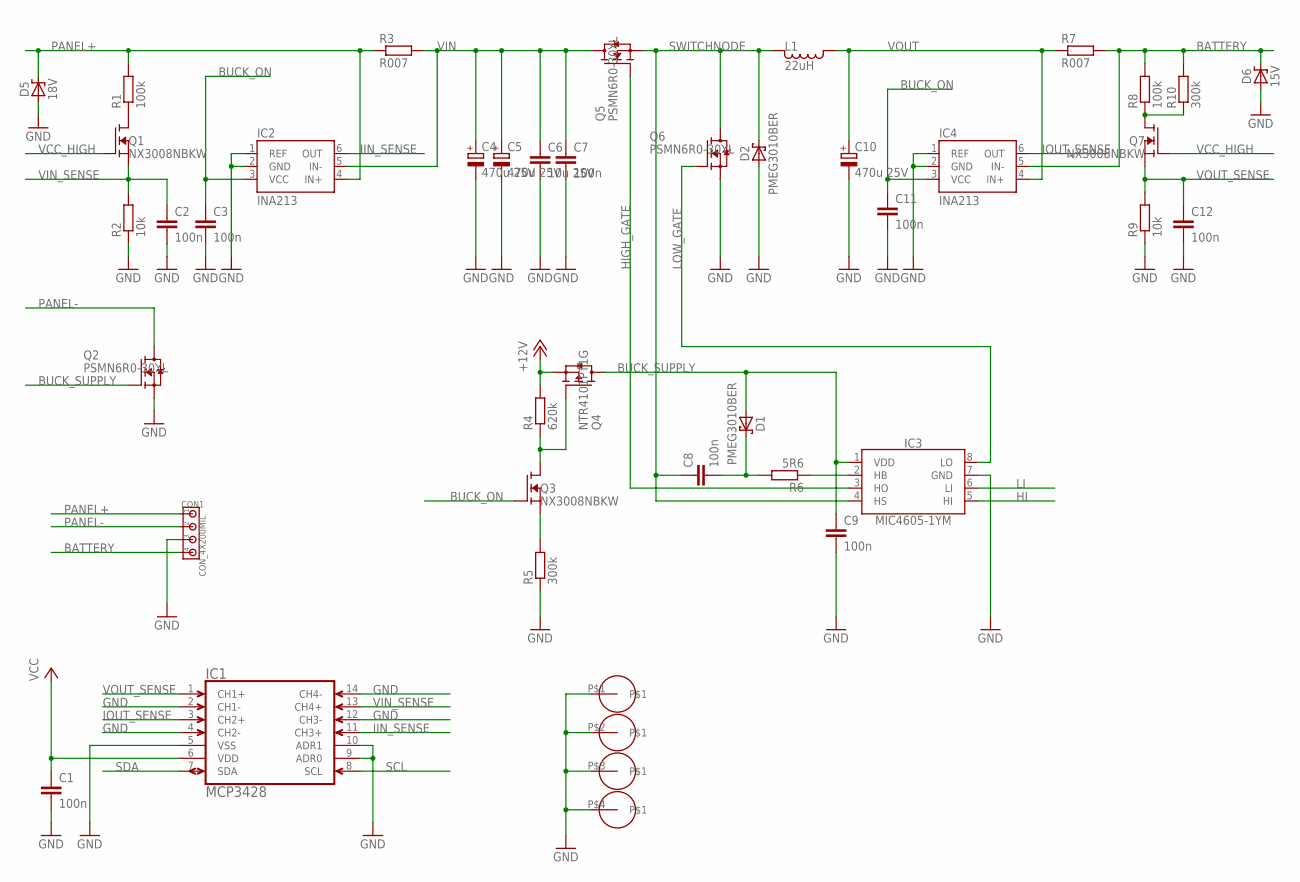
[picture p11: schematic SolarCharger_RevF.sch, sheet 1]

Parts:
C1, C2, C3, C7, C8, C9, C11, C12: 100n; C0805
C4, C5, C10: 470u 25V; 10MM
C6: 10u 25V; C1206
CON1: CON_4X200MIL; 200MIL_4X
D1, D2: PMEG3010BER; SOD123
D5: 18V; DO214AC
D6: 15V; DO214AC
DRL1: PCB_115_90
IC1: MCP3428; SO14
IC2, IC4: INA213; SC70-6
IC3: MIC4605-1YM; SOIC8
L1: 22uH; MSS1210
Q1, Q3, Q7: NX3008NBKW; SOT23
Q2, Q5, Q6: PSMN6R0-30YL; LFPAK
Q4: NTR4101PT1G; SOT23
R1, R8: 100k; R0805
R2, R9: 10k; R0805
R3, R7: R007; R1206
R4: 620k; R0805
R5, R10: 300k; R0805
R6: 5R6; R0805

Connections:
BATTERY: CON1.4, D6.C, IC4.5 (IN-), R7.2, R8.2, R10.2; also elsewhere on the board
BUCK_ON: C3.1, C11.1, IC2.3 (VCC), IC4.3 (VCC), Q3.1 (G); also elsewhere on the board
BUCK_SUPPLY: C9.1, D1.A, IC3.1 (VDD), Q2.4 (G), Q4.3 (D)
GND: C1.2, C2.2, C3.2, C4.-, C5.-, C6.2, C7.2, C9.2, C10.-, C11.2, C12.2, CON1.3, D2.A, D5.A, D6.A, DRL1.P$1, DRL1.P$2, DRL1.P$3, DRL1.P$4, IC1.2 (CH1-), IC1.4 (CH2-), IC1.5 (VSS), IC1.9 (ADR0), IC1.10 (ADR1), IC1.12 (CH3-), IC1.14 (CH4-), IC2.1 (REF), IC2.2 (GND), IC3.7 (GND), IC4.1 (REF), IC4.2 (GND), Q2.1 (S), Q2.2 (S), Q2.3 (S), Q6.1 (S), Q6.2 (S), Q6.3 (S), R2.1, R5.1, R9.1; also elsewhere on the board
HI: IC3.5 (HI); also elsewhere on the board
HIGH_GATE: IC3.3 (HO), Q5.4 (G)
IIN_SENSE: IC1.11 (CH3+), IC2.6 (OUT)
IOUT_SENSE: IC1.3 (CH2+), IC4.6 (OUT)
LI: IC3.6 (LI); also elsewhere on the board
LOW_GATE: IC3.8 (LO), Q6.4 (G)
unnamed: C8.2, D1.C, R6.2
unnamed: Q1.3 (D), R1.1
unnamed: IC3.2 (HB), R6.1
unnamed: Q3.3 (D), Q4.1 (G), R4.1
unnamed: Q7.3 (D), R8.1, R10.1
unnamed: Q3.2 (S), R5.2
PANEL+: CON1.1, D5.C, IC2.4 (IN+), R1.2, R3.1
PANEL-: CON1.2, Q2.MB1 (D), Q2.MB2 (D), Q2.MB3 (D), Q2.VIA1 (D), Q2.VIA2 (D), Q2.VIA3 (D), Q2.VIA4 (D), Q2.VIA5 (D), Q2.VIA6 (D), Q2.VIA7 (D), Q2.VIA8 (D), Q2.VIA9 (D)
SCL: IC1.8 (SCL); also elsewhere on the board
SDA: IC1.7 (SDA); also elsewhere on the board
SWITCHNODE: C8.1, D2.C, IC3.4 (HS), L1.2, L1.2B (2), L1.2C (2), L1.2D (2), L1.2E (2), L1.2F (2), L1.2G (2), L1.2H (2), Q5.1 (S), Q5.2 (S), Q5.3 (S), Q6.MB1 (D), Q6.MB2 (D), Q6.MB3 (D), Q6.VIA1 (D), Q6.VIA2 (D), Q6.VIA3 (D), Q6.VIA4 (D), Q6.VIA5 (D), Q6.VIA6 (D), Q6.VIA7 (D), Q6.VIA8 (D), Q6.VIA9 (D)
VCC: C1.1, IC1.6 (VDD); also elsewhere on the board
VCC_HIGH: Q1.1 (G), Q7.1 (G); also elsewhere on the board
VIN: C4.+, C5.+, C6.1, C7.1, IC2.5 (IN-), Q5.MB1 (D), Q5.MB2 (D), Q5.MB3 (D), Q5.VIA1 (D), Q5.VIA2 (D), Q5.VIA3 (D), Q5.VIA4 (D), Q5.VIA5 (D), Q5.VIA6 (D), Q5.VIA7 (D), Q5.VIA8 (D), Q5.VIA9 (D), R3.2
VIN_SENSE: C2.1, IC1.13 (CH4+), Q1.2 (S), R2.2
VOUT: C10.+, IC4.4 (IN+), L1.1, L1.1B (1), L1.1C (1), L1.1D (1), L1.1E (1), L1.1F (1), L1.1G (1), L1.1H (1), Q4.2 (S), R4.2, R7.1; also elsewhere on the board
VOUT_SENSE: C12.1, IC1.1 (CH1+), Q7.2 (S), R9.2

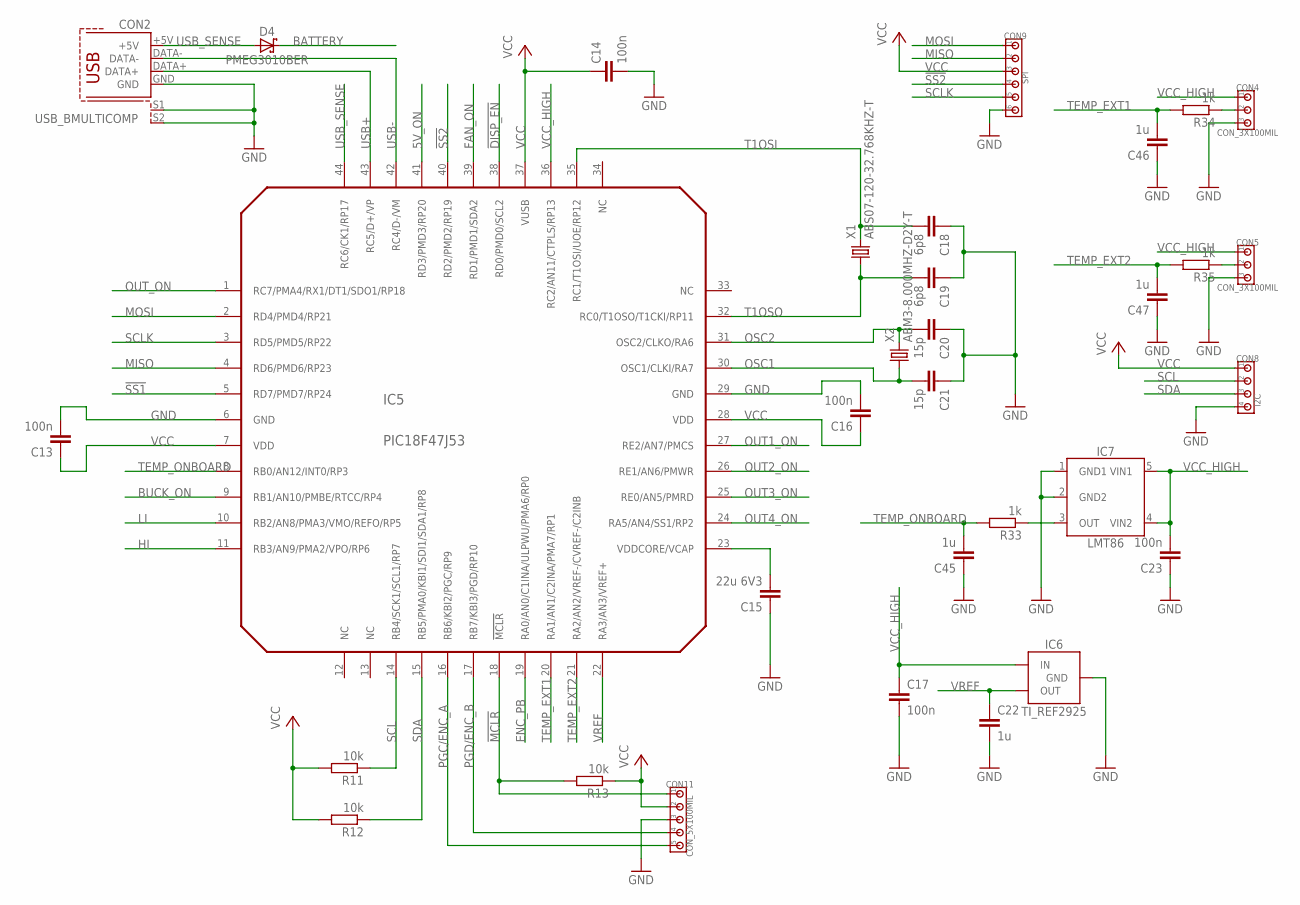
[picture p12: schematic SolarCharger_RevF.sch, sheet 2]

Parts:
C13, C14, C16, C17, C23: 100n; C0805
C15: 22u 6V3; C1206
C18, C19: 6p8; C0805
C20, C21: 15p; C0805
C22, C45, C46, C47: 1u; C0805
CON2: USB_BMULTICOMP; USB_B
CON4, CON5: CON_3X100MIL; 100MIL_3X
CON8: I2C; 100MIL_4X
CON9: SPI; 100MIL_3X2
CON11: CON_5X100MIL; 100MIL_5X
D4: PMEG3010BER; SOD123
IC5: PIC18F47J53; TQFP44
IC6: TI_REF2925; SOT23
IC7: LMT86; SC70-5
R11, R12, R13: 10k; R0805
R33, R34, R35: 1k; R0805
X1: ABS07-120-32.768KHZ-T; 3.2X1.5MM
X2: ABM3-8.000MHZ-D2Y-T; 5X3.2MM

Connections:
5V_ON: IC5.41 (RD3/PMD3/RP20); also elsewhere on the board
!DISP_EN!: IC5.38 (RD0/PMD0/SCL2); also elsewhere on the board
!MCLR!: CON11.1, IC5.18 (!MCLR!), R13.2
!SS1!: IC5.5 (RD7/PMD7/RP24); also elsewhere on the board
!SS2!: CON9.4, IC5.40 (RD2/PMD2/RP19)
BATTERY: D4.C; also elsewhere on the board
BUCK_ON: IC5.9 (RB1/AN10/PMBE/RTCC/RP4); also elsewhere on the board
ENC_PB: IC5.19 (RA0/AN0/C1INA/ULPWU/PMA6/RP0); also elsewhere on the board
FAN_ON: IC5.39 (RD1/PMD1/SDA2); also elsewhere on the board
GND: C13.2, C14.2, C15.1, C16.2, C17.2, C18.1, C19.1, C20.1, C21.1, C22.2, C23.1, C45.1, C46.1, C47.1, CON2.GND, CON2.S1, CON2.S2, CON4.3, CON5.3, CON8.4, CON9.6, CON11.3, IC5.6 (GND), IC5.29 (GND), IC6.3 (GND), IC7.1 (GND1), IC7.2 (GND2); also elsewhere on the board
HI: IC5.11 (RB3/AN9/PMA2/VPO/RP6); also elsewhere on the board
LI: IC5.10 (RB2/AN8/PMA3/VMO/REFO/RP5); also elsewhere on the board
MISO: CON9.2, IC5.4 (RD6/PMD6/RP23); also elsewhere on the board
MOSI: CON9.1, IC5.2 (RD4/PMD4/RP21); also elsewhere on the board
unnamed: C15.2, IC5.23 (VDDCORE/VCAP)
unnamed: IC7.3 (OUT), R33.1
unnamed: CON4.2, R34.1
unnamed: CON5.2, R35.1
OSC1: C21.2, IC5.30 (OSC1/CLKI/RA7), X2.1
OSC2: C20.2, IC5.31 (OSC2/CLKO/RA6), X2.2
OUT1_ON: IC5.27 (RE2/AN7/PMCS); also elsewhere on the board
OUT2_ON: IC5.26 (RE1/AN6/PMWR); also elsewhere on the board
OUT3_ON: IC5.25 (RE0/AN5/PMRD); also elsewhere on the board
OUT4_ON: IC5.24 (RA5/AN4/SS1/RP2); also elsewhere on the board
OUT_ON: IC5.1 (RC7/PMA4/RX1/DT1/SDO1/RP18); also elsewhere on the board
PGC/ENC_A: CON11.5, IC5.16 (RB6/KBI2/PGC/RP9); also elsewhere on the board
PGD/ENC_B: CON11.4, IC5.17 (RB7/KBI3/PGD/RP10); also elsewhere on the board
SCL: CON8.2, IC5.14 (RB4/SCK1/SCL1/RP7), R11.1; also elsewhere on the board
SCLK: CON9.5, IC5.3 (RD5/PMD5/RP22); also elsewhere on the board
SDA: CON8.3, IC5.15 (RB5/PMA0/KBI1/SDI1/SDA1/RP8), R12.1; also elsewhere on the board
T1OSI: C18.2, IC5.35 (RC1/T1OSI/UOE/RP12), X1.2
T1OSO: C19.2, IC5.32 (RC0/T1OSO/T1CKI/RP11), X1.1
TEMP_EXT1: C46.2, IC5.20 (RA1/AN1/C2INA/PMA7/RP1), R34.2
TEMP_EXT2: C47.2, IC5.21 (RA2/AN2/VREF-/CVREF-/C2INB), R35.2
TEMP_ONBOARD: C45.2, IC5.8 (RB0/AN12/INT0/RP3), R33.2
USB+: CON2.DATA+, IC5.43 (RC5/D+/VP)
USB-: CON2.DATA-, IC5.42 (RC4/D-/VM)
USB_SENSE: CON2.+5V, D4.A, IC5.44 (RC6/CK1/RP17)
VCC: C13.1, C14.1, C16.1, CON8.1, CON9.3, CON11.2, IC5.7 (VDD), IC5.28 (VDD), IC5.37 (VUSB), R11.2, R12.2, R13.1; also elsewhere on the board
VCC_HIGH: C17.1, C23.2, CON4.1, CON5.1, IC5.36 (RC2/AN11/CTPLS/RP13), IC6.1 (IN), IC7.4 (VIN2), IC7.5 (VIN1); also elsewhere on the board
VREF: C22.1, IC5.22 (RA3/AN3/VREF+), IC6.2 (OUT)

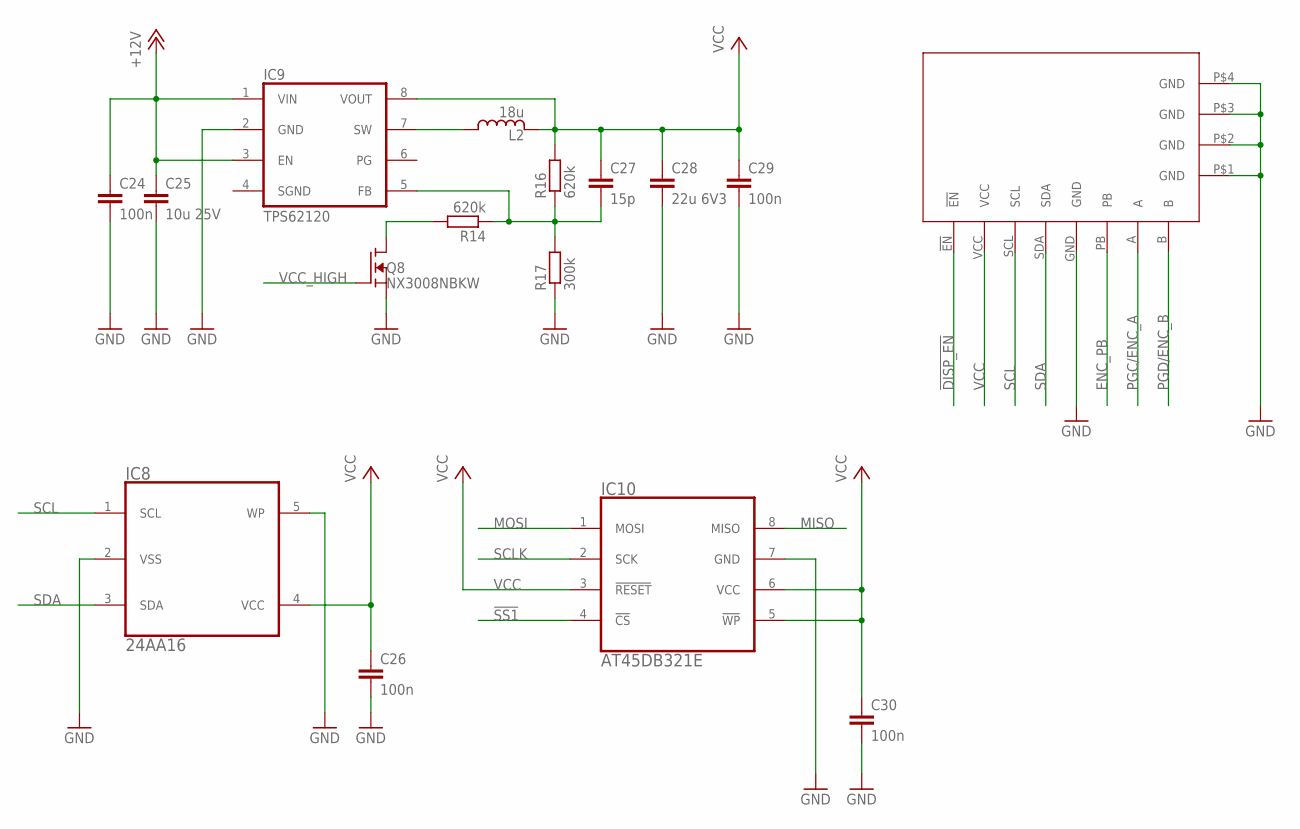
[picture p13: schematic SolarCharger_RevF.sch, sheet 3]

Parts:
BRD1: DISPLAY_UNIT
C24, C26, C29, C30: 100n; C0805
C25: 10u 25V; C1206
C27: 15p; C0805
C28: 22u 6V3; C1206
IC8: 24AA16; SOT-23-5
IC9: TPS62120; SOT-23-8
IC10: AT45DB321E; EIAJ_SOIC8
L2: 18u; LPS3015
Q8: NX3008NBKW; SOT23
R14, R16: 620k; R0805
R17: 300k; R0805

Connections:
!DISP_EN!: BRD1.!EN!; also elsewhere on the board
!SS1!: IC10.4 (!CS!); also elsewhere on the board
ENC_PB: BRD1.PB; also elsewhere on the board
GND: BRD1.GND, BRD1.P$1 (GND), BRD1.P$2 (GND), BRD1.P$3 (GND), BRD1.P$4 (GND), C24.2, C25.2, C26.2, C28.2, C29.2, C30.2, IC8.2 (VSS), IC8.5 (WP), IC9.2 (GND), IC10.7 (GND), Q8.2 (S), R17.1; also elsewhere on the board
MISO: IC10.8 (MISO); also elsewhere on the board
MOSI: IC10.1 (MOSI); also elsewhere on the board
unnamed: Q8.3 (D), R14.2
unnamed: IC9.7 (SW), L2.1, L2.1B (1), L2.1C (1), L2.1D (1), L2.1E (1)
unnamed: C27.2, IC9.5 (FB), R14.1, R16.1, R17.2
PGC/ENC_A: BRD1.A; also elsewhere on the board
PGD/ENC_B: BRD1.B; also elsewhere on the board
SCL: BRD1.SCL, IC8.1 (SCL); also elsewhere on the board
SCLK: IC10.2 (SCK); also elsewhere on the board
SDA: BRD1.SDA, IC8.3 (SDA); also elsewhere on the board
VCC: BRD1.VCC, C26.1, C27.1, C28.1, C29.1, C30.1, IC8.4 (VCC), IC9.8 (VOUT), IC10.3 (!RESET!), IC10.5 (!WP!), IC10.6 (VCC), L2.2, L2.2B (2), L2.2C (2), L2.2D (2), L2.2E (2), R16.2; also elsewhere on the board
VCC_HIGH: Q8.1 (G); also elsewhere on the board
VOUT: C24.1, C25.1, IC9.1 (VIN), IC9.3 (EN); also elsewhere on the board

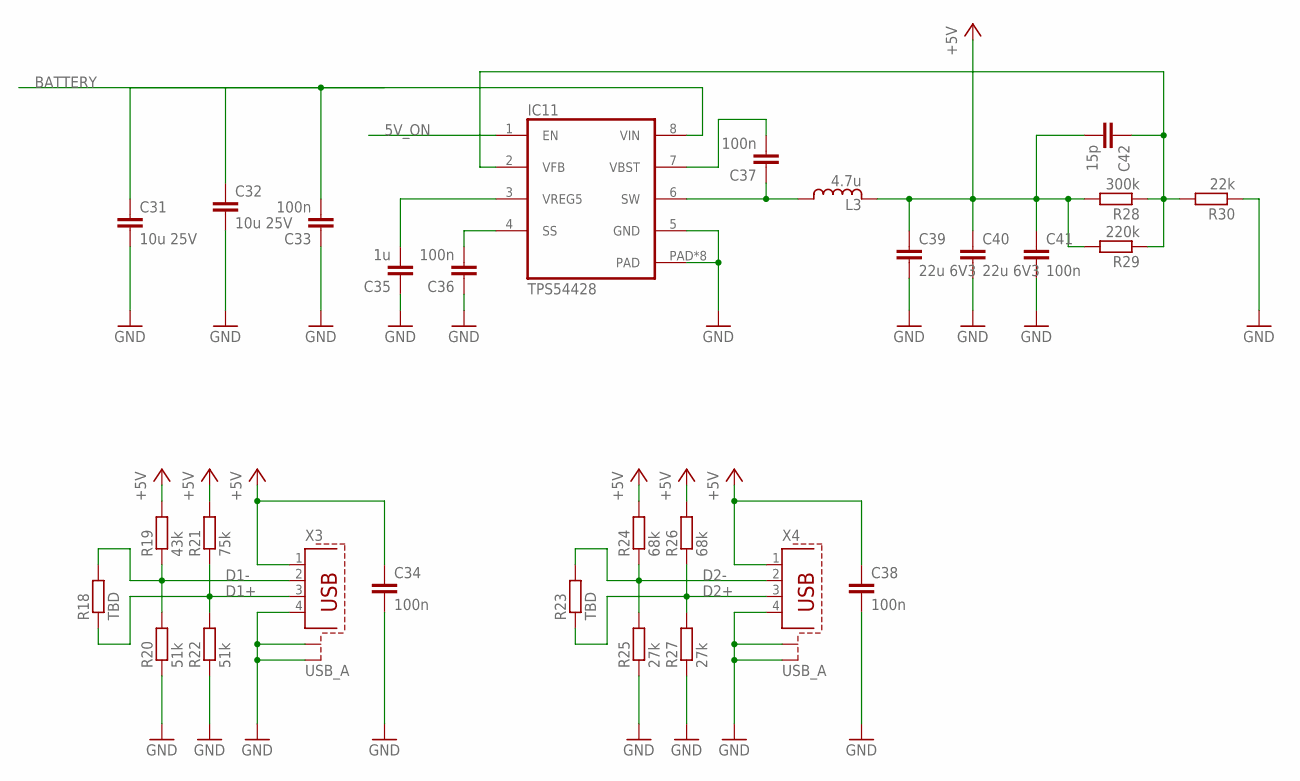
[picture p14: schematic SolarCharger_RevF.sch, sheet 4]

Parts:
C31, C32: 10u 25V; C1206
C33, C34, C36, C37, C38, C41: 100n; C0805
C35: 1u; C0805
C39, C40: 22u 6V3; C1206
C42: 15p; C0805
IC11: TPS54428; SOIC8_PWRPAD
L3: 4.7u; MSS1038
R18, R23: TBD; R0805
R19: 43k; R0805
R20, R22: 51k; R0805
R21: 75k; R0805
R24, R26: 68k; R0805
R25, R27: 27k; R0805
R28: 300k; R0805
R29: 220k; R0805
R30: 22k; R0805
X3, X4: USB_A

Connections:
5V_ON: IC11.1 (EN); also elsewhere on the board
+5V: C34.1, C38.1, C39.1, C40.1, C41.1, C42.2, L3.2, L3.2B (2), L3.2C (2), L3.2D (2), L3.2E (2), R19.2, R21.2, R24.2, R26.2, R28.2, R29.2, X3.1, X4.1
BATTERY: C31.1, C32.1, C33.2, IC11.8 (VIN); also elsewhere on the board
D1+: R18.1, R21.1, R22.2, X3.3
D1-: R18.2, R19.1, R20.2, X3.2
D2+: R23.1, R26.1, R27.2, X4.3
D2-: R23.2, R24.1, R25.2, X4.2
GND: C31.2, C32.2, C33.1, C34.2, C35.1, C36.1, C38.2, C39.2, C40.2, C41.2, IC11.5 (GND), IC11.PAD, IC11.PAD_BOTTOM (PAD), IC11.VIA1 (PAD), IC11.VIA2 (PAD), IC11.VIA3 (PAD), IC11.VIA4 (PAD), IC11.VIA5 (PAD), IC11.VIA6 (PAD), R20.1, R22.1, R25.1, R27.1, R30.1, X3.4, X3.S1, X3.S2, X4.4, X4.S1, X4.S2; also elsewhere on the board
unnamed: C37.2, IC11.7 (VBST)
unnamed: C37.1, IC11.6 (SW), L3.1, L3.1B (1), L3.1C (1), L3.1D (1), L3.1E (1)
unnamed: C35.2, IC11.3 (VREG5)
unnamed: C36.2, IC11.4 (SS)
unnamed: C42.1, IC11.2 (VFB), R28.1, R29.1, R30.2

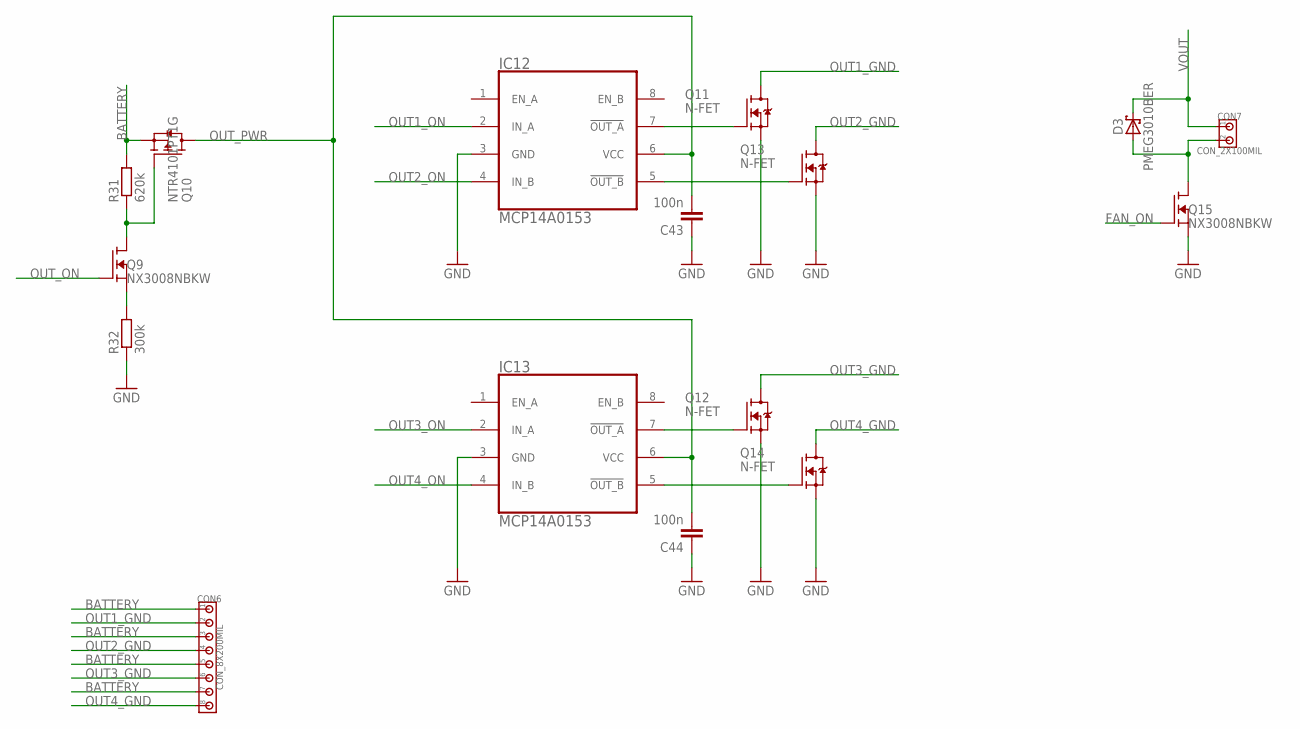
[picture p15: schematic SolarCharger_RevF.sch, sheet 5]

Parts:
C43, C44: 100n; C0805
CON6: CON_8X200MIL; 200MIL_8X
CON7: CON_2X100MIL; 100MIL_2X
D3: PMEG3010BER; SOD123
IC12, IC13: MCP14A0153; SSOP8
Q9, Q15: NX3008NBKW; SOT23
Q10: NTR4101PT1G; SOT23
Q11, Q12, Q13, Q14: N-FET; LFPAK
R31: 620k; R0805
R32: 300k; R0805

Connections:
BATTERY: CON6.1, CON6.3, CON6.5, CON6.7, Q10.2 (S), R31.2; also elsewhere on the board
FAN_ON: Q15.1 (G); also elsewhere on the board
GND: C43.1, C44.1, IC12.3 (GND), IC13.3 (GND), Q11.1 (S), Q11.2 (S), Q11.3 (S), Q12.1 (S), Q12.2 (S), Q12.3 (S), Q13.1 (S), Q13.2 (S), Q13.3 (S), Q14.1 (S), Q14.2 (S), Q14.3 (S), Q15.2 (S), R32.1; also elsewhere on the board
unnamed: Q9.3 (D), Q10.1 (G), R31.1
unnamed: CON7.2, D3.A, Q15.3 (D)
unnamed: IC12.7 (!OUT_A!), Q11.4 (G)
unnamed: IC13.5 (!OUT_B!), Q14.4 (G)
unnamed: IC13.7 (!OUT_A!), Q12.4 (G)
unnamed: IC12.5 (!OUT_B!), Q13.4 (G)
unnamed: Q9.2 (S), R32.2
OUT1_GND: CON6.2, Q11.MB1 (D), Q11.MB2 (D), Q11.MB3 (D), Q11.VIA1 (D), Q11.VIA2 (D), Q11.VIA3 (D), Q11.VIA4 (D), Q11.VIA5 (D), Q11.VIA6 (D), Q11.VIA7 (D), Q11.VIA8 (D), Q11.VIA9 (D)
OUT1_ON: IC12.2 (IN_A); also elsewhere on the board
OUT2_GND: CON6.4, Q13.MB1 (D), Q13.MB2 (D), Q13.MB3 (D), Q13.VIA1 (D), Q13.VIA2 (D), Q13.VIA3 (D), Q13.VIA4 (D), Q13.VIA5 (D), Q13.VIA6 (D), Q13.VIA7 (D), Q13.VIA8 (D), Q13.VIA9 (D)
OUT2_ON: IC12.4 (IN_B); also elsewhere on the board
OUT3_GND: CON6.6, Q12.MB1 (D), Q12.MB2 (D), Q12.MB3 (D), Q12.VIA1 (D), Q12.VIA2 (D), Q12.VIA3 (D), Q12.VIA4 (D), Q12.VIA5 (D), Q12.VIA6 (D), Q12.VIA7 (D), Q12.VIA8 (D), Q12.VIA9 (D)
OUT3_ON: IC13.2 (IN_A); also elsewhere on the board
OUT4_GND: CON6.8, Q14.MB1 (D), Q14.MB2 (D), Q14.MB3 (D), Q14.VIA1 (D), Q14.VIA2 (D), Q14.VIA3 (D), Q14.VIA4 (D), Q14.VIA5 (D), Q14.VIA6 (D), Q14.VIA7 (D), Q14.VIA8 (D), Q14.VIA9 (D)
OUT4_ON: IC13.4 (IN_B); also elsewhere on the board
OUT_ON: Q9.1 (G); also elsewhere on the board
OUT_PWR: C43.2, C44.2, IC12.6 (VCC), IC13.6 (VCC), Q10.3 (D)
VOUT: CON7.1, D3.C; also elsewhere on the board

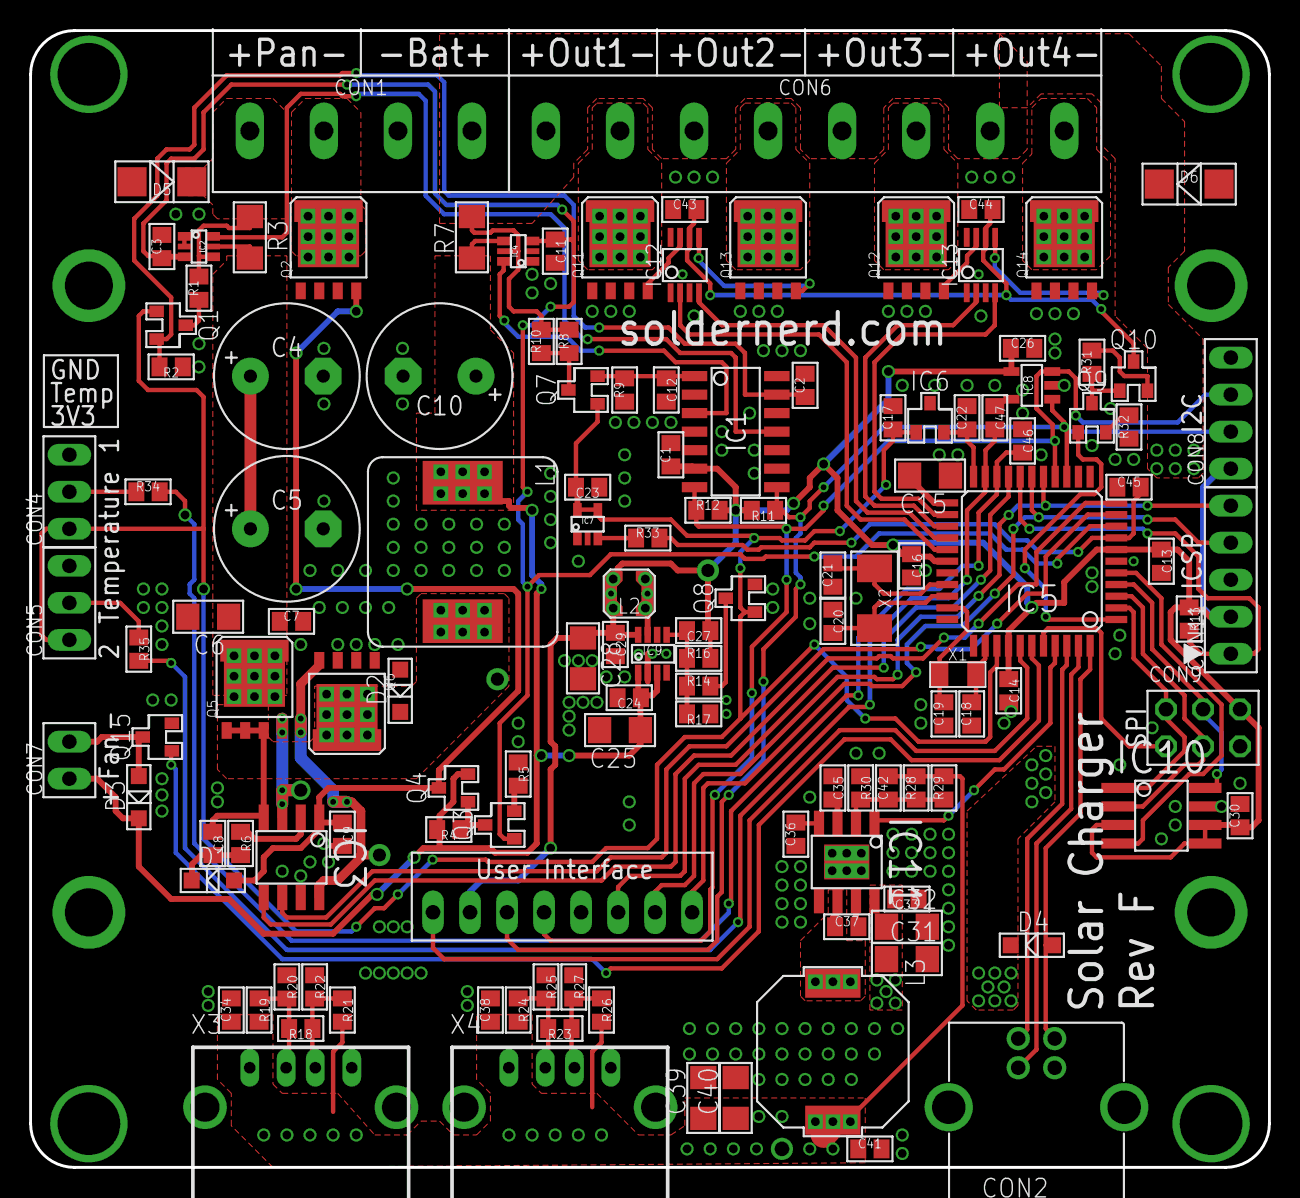
[picture p16: board SolarCharger_RevF.brd from above]

Board: 2 copper layers, 85.0 x 78.0 mm, 133 parts (0 on the bottom side), 84 nets.
