soldernerd/SolarChargerHardware/SolarCharger_Rev2.brd

## EAGLE design SolarCharger_Rev2.brd (2017-01-07)

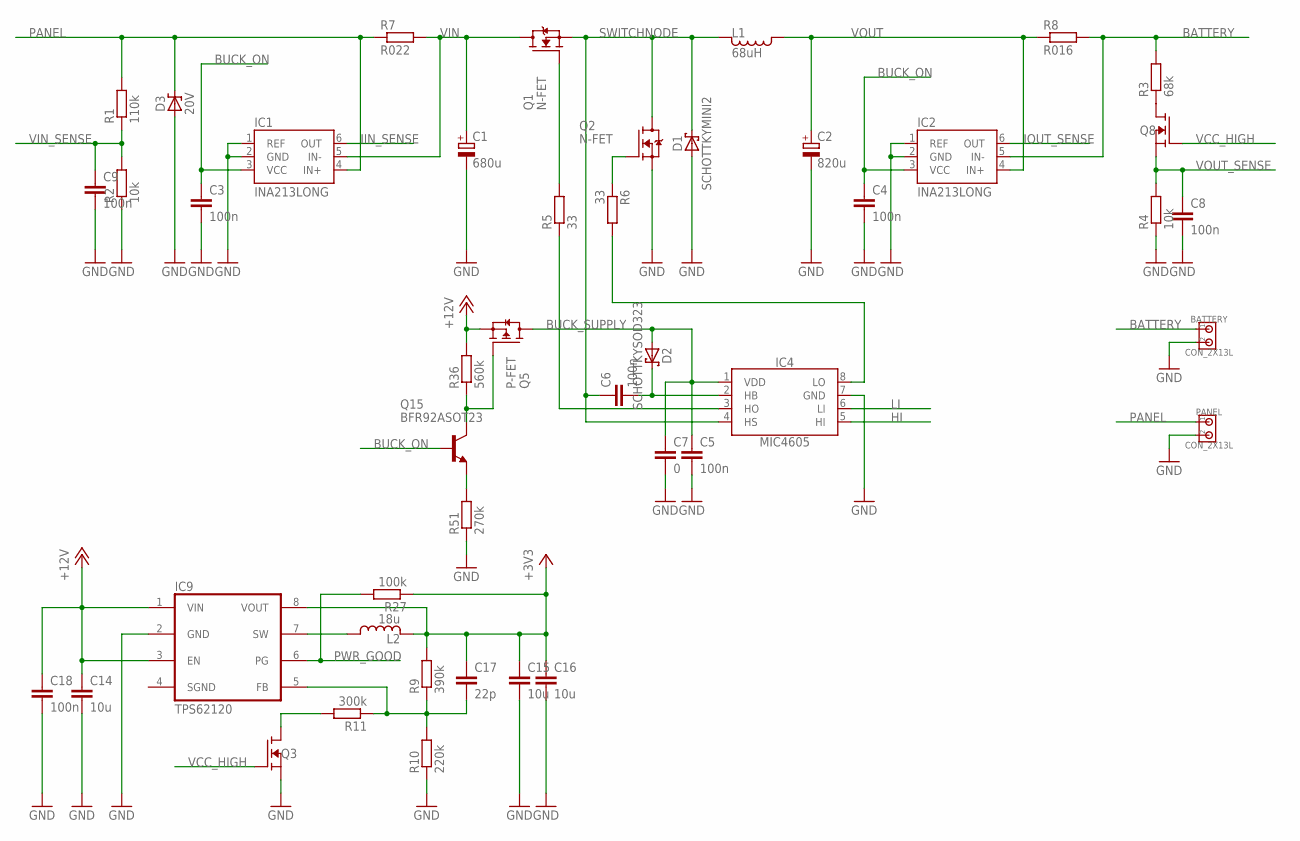
[picture p17: schematic SolarCharger_Rev2.sch, sheet 1]

Parts:
BATTERY: CON_2X13L; 200MIL_2X
C1: 680u; 10MM
C2: 820u; 10MM
C3, C4, C5, C6, C8, C9: 100n; C0805
C7: 0; C0805
C14: 10u; C1206
C15, C16: 10u; C0805
C17: 22p; C0805
C18: 100n; C1206
D1: SCHOTTKYMINI2; MINI2-F3-B
D2: SCHOTTKYSOD323; SOD323
D3: 20V; SMC
IC1, IC2: INA213LONG; SC70-6_LONG
IC4: MIC4605; SOIC8
IC9: TPS62120; SOT-23-8
L1: 68uH; MSS1583
L2: 18u; LPS3015
PANEL: CON_2X13L; 200MIL_2X
Q1, Q2: N-FET; TO263-3
Q3, Q8: N-FETSOT23; SOT23
Q5: P-FET; SOT23
Q15: BFR92ASOT23; SOT23
R1: 110k; R0805
R2, R4: 10k; R0805
R3: 68k; R0805
R5, R6: 33; R0805
R7: R022; 0612
R8: R016; 0612
R9: 390k; R0805
R10: 220k; R0805
R11: 300k; R0805
R27: 100k; R0805
R36: 560k; R0805
R51: 270k; R0805

Connections:
BATTERY: BATTERY.1, IC2.5 (IN-), R3.2, R8.2; also elsewhere on the board
BUCK_ON: C3.1, C4.1, IC1.3 (VCC), IC2.3 (VCC), Q15.1 (B); also elsewhere on the board
BUCK_SUPPLY: C5.1, C7.1, D2.A, IC4.1 (VDD), Q5.3 (D)
GND: BATTERY.2, C1.-, C2.-, C3.2, C4.2, C5.2, C7.2, C8.2, C9.2, C14.2, C15.2, C16.2, C18.2, D1.A, D3.A, IC1.1 (REF), IC1.2 (GND), IC2.1 (REF), IC2.2 (GND), IC4.7 (GND), IC9.2 (GND), PANEL.2, Q2.3 (S), Q3.2 (S), R2.1, R4.1, R10.1, R51.1; also elsewhere on the board
HI: IC4.5 (HI); also elsewhere on the board
IIN_SENSE: IC1.6 (OUT); also elsewhere on the board
IOUT_SENSE: IC2.6 (OUT); also elsewhere on the board
LI: IC4.6 (LI); also elsewhere on the board
unnamed: C6.2, D2.C, IC4.2 (HB)
unnamed: Q1.1 (G), R5.2
unnamed: Q3.3 (D), R11.2
unnamed: Q2.1 (G), R6.1
unnamed: IC4.8 (LO), R6.2
unnamed: IC9.7 (SW), L2.1
unnamed: C17.2, IC9.5 (FB), R9.1, R10.2, R11.1
unnamed: IC4.3 (HO), R5.1
unnamed: Q5.1 (G), Q15.3 (C), R36.1
unnamed: Q8.3 (D), R3.1
unnamed: Q15.2 (E), R51.2
PANEL: D3.C, IC1.4 (IN+), PANEL.1, R1.2, R7.1
PWR_GOOD: IC9.6 (PG), R27.2; also elsewhere on the board
SWITCHNODE: C6.1, D1.C, IC4.4 (HS), L1.2, Q1.3 (S), Q2.TAB (D)
VCC: C15.1, C16.1, C17.1, IC9.8 (VOUT), L2.2, R9.2, R27.1; also elsewhere on the board
VCC_HIGH: Q3.1 (G), Q8.1 (G); also elsewhere on the board
VIN: C1.+, IC1.5 (IN-), Q1.TAB (D), R7.2
VIN_SENSE: C9.1, R1.1, R2.2; also elsewhere on the board
VOUT: C2.+, C14.1, C18.1, IC2.4 (IN+), IC9.1 (VIN), IC9.3 (EN), L1.1, Q5.2 (S), R8.1, R36.2; also elsewhere on the board
VOUT_SENSE: C8.1, Q8.2 (S), R4.2; also elsewhere on the board
