soldernerd/SolarChargerHardware/SolarCharger_Rev2.brd

## EAGLE design SolarCharger_Rev2.brd (continued)

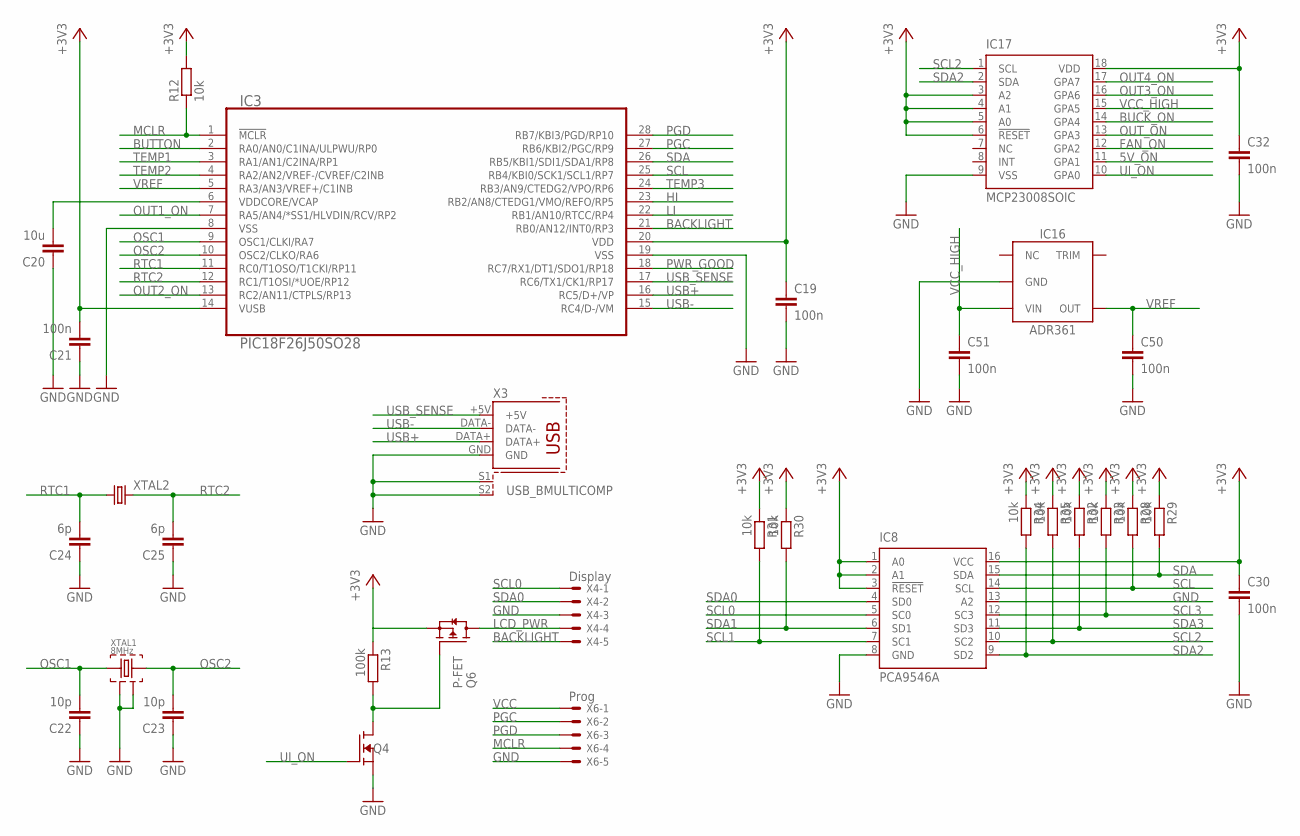
[picture p18: schematic SolarCharger_Rev2.sch, sheet 2]

Parts:
C19, C21, C30, C32, C50, C51: 100n; C0805
C20: 10u; C0805
C22, C23: 10p; C0805
C24, C25: 6p; C0805
IC3: PIC18F26J50SO28; SO28W
IC8: PCA9546A; SO16
IC16: ADR361; SOT23-5
IC17: MCP23008SOIC; SO18W
Q4: N-FETSOT23; SOT23
Q6: P-FET; SOT23
R12, R28, R29, R30, R31, R32, R33, R34, R35: 10k; R0805
R13: 100k; R0805
X3: USB_BMULTICOMP; USB_B
X4: Display; 22-23-2051
X6: Prog; 22-23-2051
XTAL1: 8MHz; 5X3.2MM
XTAL2: CRYSTAL3.2X1.5; 3.2X1.5MM

Connections:
5V_ON: IC17.11 (GPA1); also elsewhere on the board
BACKLIGHT: IC3.21 (RB0/AN12/INT0/RP3), X4.5
BUCK_ON: IC17.14 (GPA4); also elsewhere on the board
BUTTON: IC3.2 (RA0/AN0/C1INA/ULPWU/RP0); also elsewhere on the board
FAN_ON: IC17.12 (GPA2); also elsewhere on the board
GND: C19.2, C20.1, C21.1, C22.1, C23.1, C24.1, C25.1, C30.2, C32.2, C50.2, C51.2, IC3.8 (VSS), IC3.19 (VSS), IC8.8 (GND), IC8.13 (A2), IC16.2 (GND), IC17.9 (VSS), Q4.2 (S), X3.GND, X3.S1, X3.S2, X4.3, X6.5, XTAL1.2, XTAL1.4; also elsewhere on the board
HI: IC3.23 (RB2/AN8/CTEDG1/VMO/REFO/RP5); also elsewhere on the board
LCD_PWR: Q6.3 (D), X4.4
LI: IC3.22 (RB1/AN10/RTCC/RP4); also elsewhere on the board
MCLR: IC3.1 (!MCLR!), R12.1, X6.4
unnamed: Q4.3 (D), Q6.1 (G), R13.2
unnamed: C20.2, IC3.6 (VDDCORE/VCAP)
OSC1: C22.2, IC3.9 (OSC1/CLKI/RA7), XTAL1.1
OSC2: C23.2, IC3.10 (OSC2/CLKO/RA6), XTAL1.3
OUT1_ON: IC3.7 (RA5/AN4/*SS1/HLVDIN/RCV/RP2); also elsewhere on the board
OUT2_ON: IC3.13 (RC2/AN11/CTPLS/RP13); also elsewhere on the board
OUT3_ON: IC17.16 (GPA6); also elsewhere on the board
OUT4_ON: IC17.17 (GPA7); also elsewhere on the board
OUT_ON: IC17.13 (GPA3); also elsewhere on the board
PGC: IC3.27 (RB6/KBI2/PGC/RP9), X6.2; also elsewhere on the board
PGD: IC3.28 (RB7/KBI3/PGD/RP10), X6.3; also elsewhere on the board
PWR_GOOD: IC3.18 (RC7/RX1/DT1/SDO1/RP18); also elsewhere on the board
RTC1: C24.2, IC3.11 (RC0/T1OSO/T1CKI/RP11), XTAL2.1
RTC2: C25.2, IC3.12 (RC1/T1OSI/*UOE/RP12), XTAL2.2
SCL: IC3.25 (RB4/KBI0/SCK1/SCL1/RP7), IC8.14 (SCL), R28.2
SCL0: IC8.5 (SC0), X4.1
SCL1: IC8.7 (SC1), R31.2; also elsewhere on the board
SCL2: IC8.10 (SC2), IC17.1 (SCL), R35.2
SCL3: IC8.12 (SC3), R33.2; also elsewhere on the board
SDA: IC3.26 (RB5/KBI1/SDI1/SDA1/RP8), IC8.15 (SDA), R29.2
SDA0: IC8.4 (SD0), X4.2
SDA1: IC8.6 (SD1), R30.2; also elsewhere on the board
SDA2: IC8.9 (SD2), IC17.2 (SDA), R34.2
SDA3: IC8.11 (SD3), R32.2; also elsewhere on the board
TEMP1: IC3.3 (RA1/AN1/C2INA/RP1); also elsewhere on the board
TEMP2: IC3.4 (RA2/AN2/VREF-/CVREF/C2INB); also elsewhere on the board
TEMP3: IC3.24 (RB3/AN9/CTEDG2/VPO/RP6); also elsewhere on the board
UI_ON: IC17.10 (GPA0), Q4.1 (G); also elsewhere on the board
USB+: IC3.16 (RC5/D+/VP), X3.DATA+
USB-: IC3.15 (RC4/D-/VM), X3.DATA-
USB_SENSE: IC3.17 (RC6/TX1/CK1/RP17), X3.+5V
VCC: C19.1, C21.2, C30.1, C32.1, IC3.14 (VUSB), IC3.20 (VDD), IC8.1 (A0), IC8.2 (A1), IC8.3 (!RESET!), IC8.16 (VCC), IC17.3 (A2), IC17.4 (A1), IC17.5 (A0), IC17.6 (!RESET), IC17.18 (VDD), Q6.2 (S), R12.2, R13.1, R28.1, R29.1, R30.1, R31.1, R32.1, R33.1, R34.1, R35.1, X6.1; also elsewhere on the board
VCC_HIGH: C51.1, IC16.3 (VIN), IC17.15 (GPA5); also elsewhere on the board
VREF: C50.1, IC3.5 (RA3/AN3/VREF+/C1INB), IC16.4 (OUT)

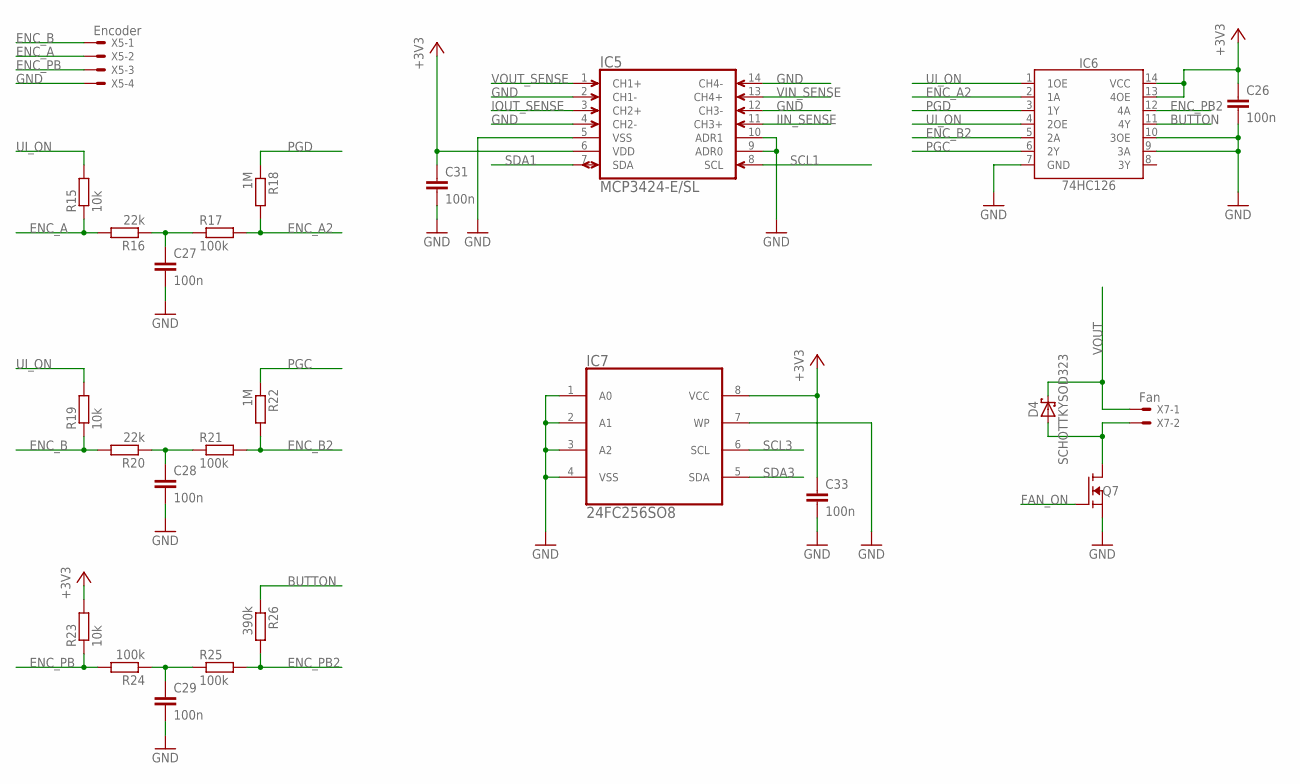
[picture p19: schematic SolarCharger_Rev2.sch, sheet 3]

Parts:
C26, C27, C28, C29, C31, C33: 100n; C0805
D4: SCHOTTKYSOD323; SOD323
IC5: MCP3424-E/SL; SOIC14
IC6: 74HC126; SO14
IC7: 24FC256SO8; SOIC8
Q7: N-FETSOT23; SOT23
R15, R19, R23: 10k; R0805
R16, R20: 22k; R0805
R17, R21, R24, R25: 100k; R0805
R18, R22: 1M; R0805
R26: 390k; R0805
X5: Encoder; 22-23-2041
X7: Fan; 22-23-2021

Connections:
BUTTON: IC6.11 (4Y), R26.1; also elsewhere on the board
ENC_A: R15.1, R16.2, X5.2
ENC_A2: IC6.2 (1A), R17.2, R18.2
ENC_B: R19.1, R20.2, X5.1
ENC_B2: IC6.5 (2A), R21.2, R22.2
ENC_PB: R23.1, R24.2, X5.3
ENC_PB2: IC6.12 (4A), R25.2, R26.2
FAN_ON: Q7.1 (G); also elsewhere on the board
GND: C26.2, C27.2, C28.2, C29.2, C31.2, C33.2, IC5.2 (CH1-), IC5.4 (CH2-), IC5.5 (VSS), IC5.9 (ADR0), IC5.10 (ADR1), IC5.12 (CH3-), IC5.14 (CH4-), IC6.7 (GND), IC6.9 (3A), IC6.10 (3OE), IC7.1 (A0), IC7.2 (A1), IC7.3 (A2), IC7.4 (VSS), IC7.7 (WP), Q7.2 (S), X5.4; also elsewhere on the board
IIN_SENSE: IC5.11 (CH3+); also elsewhere on the board
IOUT_SENSE: IC5.3 (CH2+); also elsewhere on the board
unnamed: C28.1, R20.1, R21.1
unnamed: D4.A, Q7.3 (D), X7.2
unnamed: C27.1, R16.1, R17.1
unnamed: C29.1, R24.1, R25.1
PGC: IC6.6 (2Y), R22.1; also elsewhere on the board
PGD: IC6.3 (1Y), R18.1; also elsewhere on the board
SCL1: IC5.8 (SCL); also elsewhere on the board
SCL3: IC7.6 (SCL); also elsewhere on the board
SDA1: IC5.7 (SDA); also elsewhere on the board
SDA3: IC7.5 (SDA); also elsewhere on the board
UI_ON: IC6.1 (1OE), IC6.4 (2OE), R15.2, R19.2; also elsewhere on the board
VCC: C26.1, C31.1, C33.1, IC5.6 (VDD), IC6.13 (4OE), IC6.14 (VCC), IC7.8 (VCC), R23.2; also elsewhere on the board
VIN_SENSE: IC5.13 (CH4+); also elsewhere on the board
VOUT: D4.C, X7.1; also elsewhere on the board
VOUT_SENSE: IC5.1 (CH1+); also elsewhere on the board

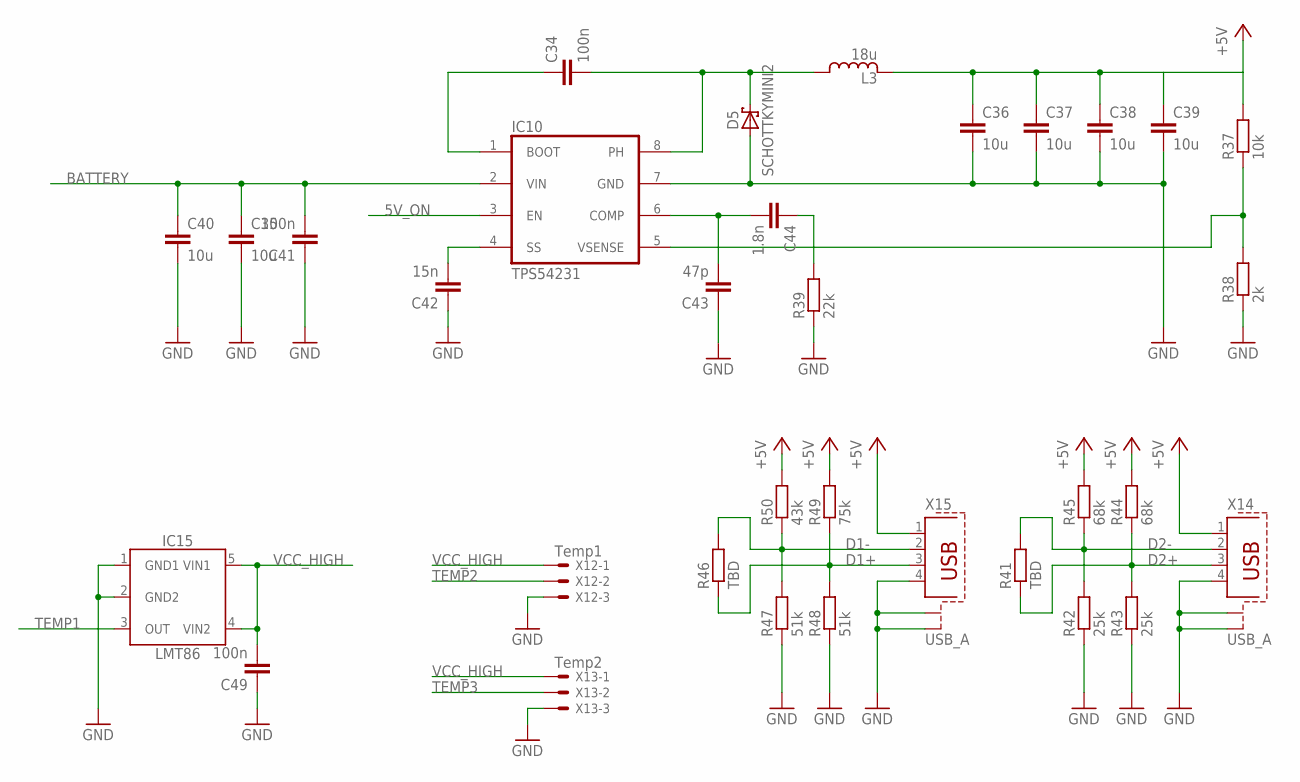
[picture p20: schematic SolarCharger_Rev2.sch, sheet 4]

Parts:
C34, C41, C49: 100n; C0805
C35, C36, C37, C38, C39, C40: 10u; C1206
C42: 15n; C0805
C43: 47p; C0805
C44: 1.8n; C0805
D5: SCHOTTKYMINI2; MINI2-F3-B
IC10: TPS54231; SO8
IC15: LMT86; SC70-5
L3: 18u; MSS1038
R37: 10k; R0805
R38: 2k; R0805
R39: 22k; R0805
R41, R46: TBD; R0805
R42, R43: 25k; R0805
R44, R45: 68k; R0805
R47, R48: 51k; R0805
R49: 75k; R0805
R50: 43k; R0805
X12: Temp1; 22-23-2031
X13: Temp2; 22-23-2031
X14, X15: USB_A

Connections:
5V_ON: IC10.3 (EN); also elsewhere on the board
+5V: C36.1, C37.1, C38.1, C39.1, L3.2, R37.2, R44.2, R45.2, R49.2, R50.2, X14.1, X15.1
BATTERY: C35.1, C40.1, C41.2, IC10.2 (VIN); also elsewhere on the board
D1+: R46.1, R48.2, R49.1, X15.3
D1-: R46.2, R47.2, R50.1, X15.2
D2+: R41.1, R43.2, R44.1, X14.3
D2-: R41.2, R42.2, R45.1, X14.2
GND: C35.2, C36.2, C37.2, C38.2, C39.2, C40.2, C41.1, C42.1, C43.1, C49.1, D5.A, IC10.7 (GND), IC15.1 (GND1), IC15.2 (GND2), R38.1, R39.1, R42.1, R43.1, R47.1, R48.1, X12.3, X13.3, X14.4, X14.S1, X14.S2, X15.4, X15.S1, X15.S2; also elsewhere on the board
unnamed: C34.1, IC10.1 (BOOT)
unnamed: C42.2, IC10.4 (SS)
unnamed: C34.2, D5.C, IC10.8 (PH), L3.1
unnamed: IC10.5 (VSENSE), R37.1, R38.2
unnamed: C44.1, R39.2
unnamed: C43.2, C44.2, IC10.6 (COMP)
TEMP1: IC15.3 (OUT); also elsewhere on the board
TEMP2: X12.2; also elsewhere on the board
TEMP3: X13.2; also elsewhere on the board
VCC_HIGH: C49.2, IC15.4 (VIN2), IC15.5 (VIN1), X12.1, X13.1; also elsewhere on the board

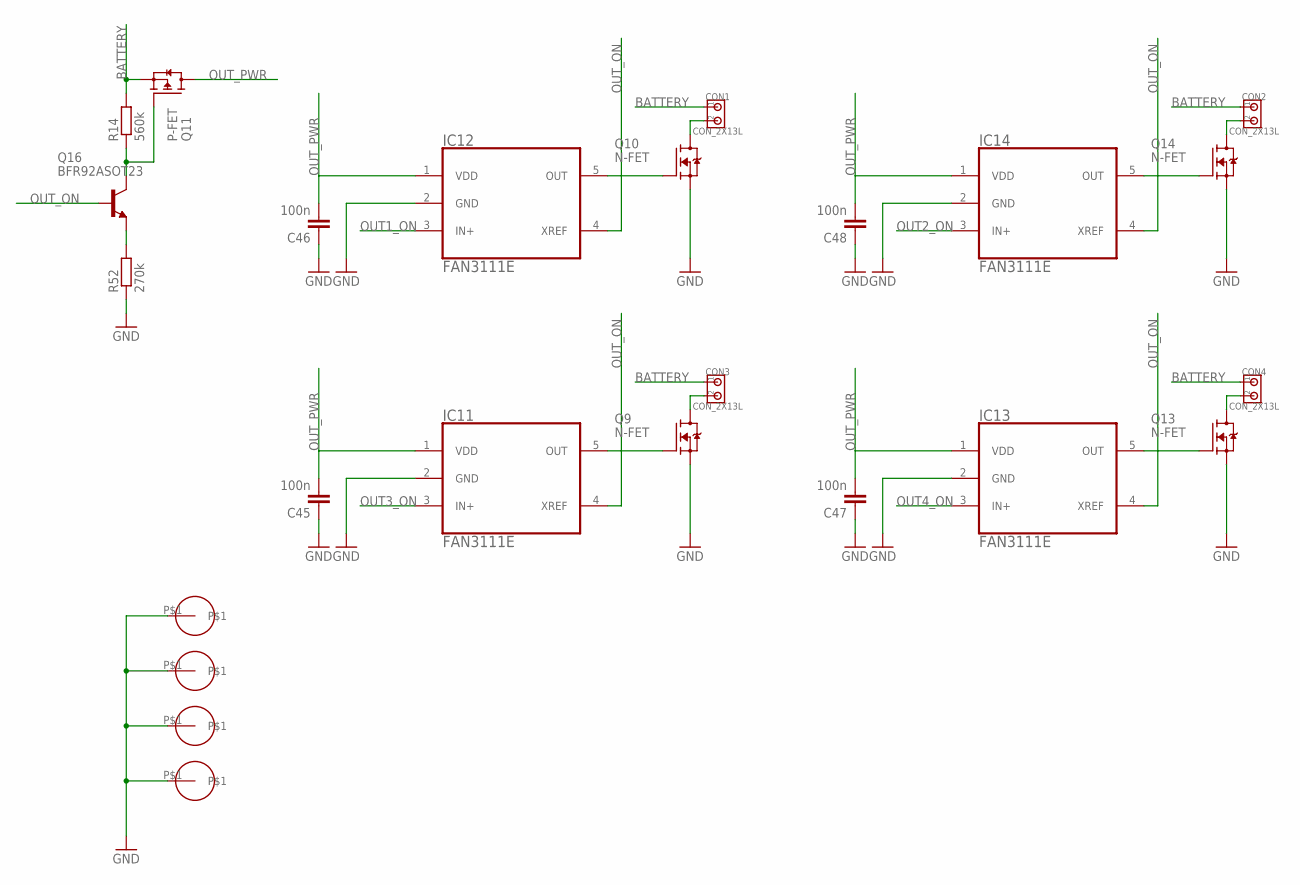
[picture p21: schematic SolarCharger_Rev2.sch, sheet 5]

Parts:
C45, C46, C47, C48: 100n; C0805
CON1, CON2, CON3, CON4: CON_2X13L; 200MIL_2X
IC11, IC12, IC13, IC14: FAN3111E; SOT-23-5
Q9, Q10, Q13, Q14: N-FET; TO263-3
Q11: P-FET; SOT23
Q16: BFR92ASOT23; SOT23
R14: 560k; R0805
R52: 270k; R0805
U$1, U$2, U$3, U$4: HOLE_3.3MM

Connections:
BATTERY: CON1.1, CON2.1, CON3.1, CON4.1, Q11.2 (S), R14.2; also elsewhere on the board
GND: C45.1, C46.1, C47.1, C48.1, IC11.2 (GND), IC12.2 (GND), IC13.2 (GND), IC14.2 (GND), Q9.3 (S), Q10.3 (S), Q13.3 (S), Q14.3 (S), R52.1, U$1.P$1, U$2.P$1, U$3.P$1, U$4.P$1; also elsewhere on the board
unnamed: Q11.1 (G), Q16.3 (C), R14.1
unnamed: CON3.2, Q9.TAB (D)
unnamed: IC11.5 (OUT), Q9.1 (G)
unnamed: CON1.2, Q10.TAB (D)
unnamed: IC12.5 (OUT), Q10.1 (G)
unnamed: CON4.2, Q13.TAB (D)
unnamed: IC13.5 (OUT), Q13.1 (G)
unnamed: CON2.2, Q14.TAB (D)
unnamed: IC14.5 (OUT), Q14.1 (G)
unnamed: Q16.2 (E), R52.2
OUT1_ON: IC12.3 (IN+); also elsewhere on the board
OUT2_ON: IC14.3 (IN+); also elsewhere on the board
OUT3_ON: IC11.3 (IN+); also elsewhere on the board
OUT4_ON: IC13.3 (IN+); also elsewhere on the board
OUT_ON: IC11.4 (XREF), IC12.4 (XREF), IC13.4 (XREF), IC14.4 (XREF), Q16.1 (B); also elsewhere on the board
OUT_PWR: C45.2, C46.2, C47.2, C48.2, IC11.1 (VDD), IC12.1 (VDD), IC13.1 (VDD), IC14.1 (VDD), Q11.3 (D)

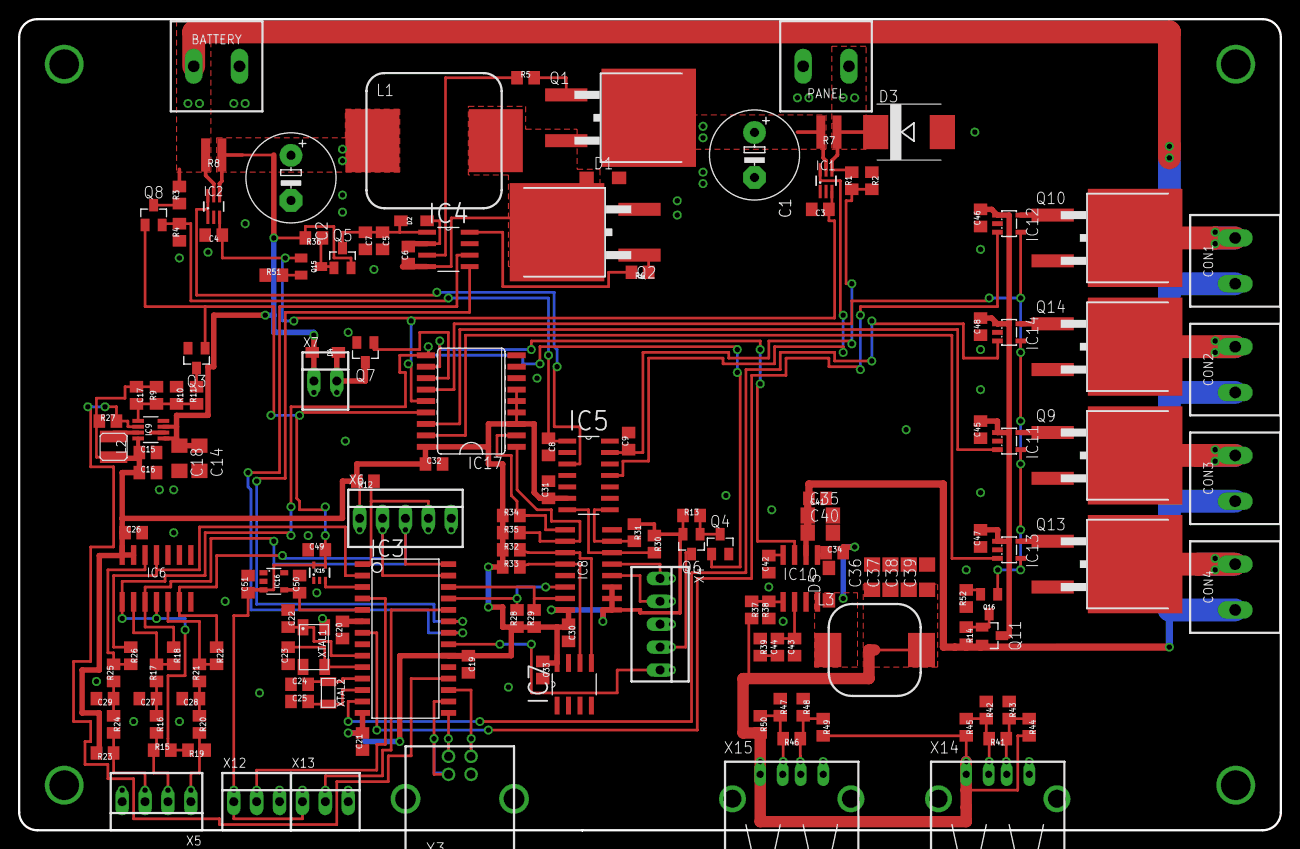
[picture p22: board SolarCharger_Rev2.brd from above]

Board: 2 copper layers, 140.0 x 90.0 mm, 159 parts (0 on the bottom side), 97 nets.
