soldernerd/SolarChargerHardware/(commit log)

2017-03-18 Some resistor values fixed
    [SolarCharger_RevC.brd, SolarCharger_RevC.sch]
2017-06-06 Some resistor values changed
    [SolarCharger_RevC.brd, SolarCharger_RevC.sch]
2017-09-04 Revision D completed
    [SolarCharger_RevD.brd, SolarCharger_RevD.sch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]
2017-09-11 Power supply for high voltage version more or less final. Schematics only, no layout yet.
    [SolarChargerHV_RevA.brd, SolarChargerHV_RevA.sch]
2017-09-14 Buck for high voltage version nearly completed. Mosfet footprint still to be changed. Low-side current sensing implemented
    [SolarChargerHV_RevA.brd, SolarChargerHV_RevA.sch]
2017-10-28 Flash now supplied directly from VCC
    [SolarChargerHV_RevA.brd, SolarChargerHV_RevA.sch, SolarCharger_RevC_BOM.xlsx, SolarCharger_RevD.brd, SolarCharger_RevD.sch, SolarCharger_RevD_BOM.xlsx, SolarCharger_RevD_BOM2.xlsx]
2018-01-01 Revision E completed. Now with SPI and I2C headers
    [SolarCharger_RevE.brd, SolarCharger_RevE.sch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]
2018-01-01 Some ground connections improved
    [SolarCharger_RevE.brd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]
2018-01-02 Some final minor changes. Moved a capacitor, re-routed a VCC trace. Gerbers exported as ordered
    [SolarCharger_RevE.sch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]
2018-01-07 Rev F files added. Switched pins for FAN_OUT and SS2
    [SolarCharger_RevF.brd, SolarCharger_RevF.sch]
2018-02-18 Revision F: Just swapped 2 signals
    [SolarCharger_RevD_BOM.xlsx, SolarCharger_RevE.brd, SolarCharger_RevE.sch, SolarCharger_RevF.brd, SolarCharger_RevF.sch, SolarCharger_RevF_BOM.xlsx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]
2018-06-25 Slightly modified the board (but noch schematics) of the Arduino version. The new version is intended for a professionally etched board with plated through vias, silkscreen and all.
    [SolarCharger_Rev1_revised.brd, SolarCharger_Rev1_revised.sch, SolarCharger_RevF_BOM.xlsx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]
